sequoia-hope/rp2350-motor-controller/hardware/docs/snor027/LM73100_Design_Calculator.xlsm

Sheet: Calculation Sheet
LM73100 Design Calculation Tool
 | Constants Cells
 | Input/SelectCells
 | Calculation Cells
 | Calculated, but can be over-ridden by user
 | Error Cells, Must be Fixed
Parameter | Description | Value | Units | Tolerance | Recommended Value
VIN (max) | Maximum Operating input voltage (magnitude) | 12.00 | V
OVLO Set Point | Desired Over Voltage Lockout Set Point | 13.20 | V | 3.0%
UVLO Set Point | Desired Undervoltage Threshold (VIN Rising) | 10.80 | V | 3.0%
VUVP | Internal Undervoltage Protection Threshold (VIN Rising) | 2.53 | V | 3.0%
Cout | Load Capacitance | 470.0 | uF | 10.0%
Rlstart | Load at startup | 100.0 | Ohm |  | 2.4
Load turn on voltage | Output voltage at which startup load will start drawing current | 0 | V
Imax | Maximum continuous load current (magnitude) | 5.00 | A
TA, MAX | Maximum Operating Ambient temperature | 25.00 | °C
UVLO, OVLO set point calculations |  |  |  |  |  |  |  |  | R2+R3
UVLO Set Point | Desired Undervoltage Threshold (VIN Rising) | 10.80 |  |  |  |  |  |  | 58.75
OVLO Set Point | Desired Over Voltage Lockout Set Point | 13.20 |  |  |  |  | 9.80 | Power Fail (VIN Falling) | R2
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
