sequoia-hope/rp2350-motor-controller/review/img/enc_full-1.png

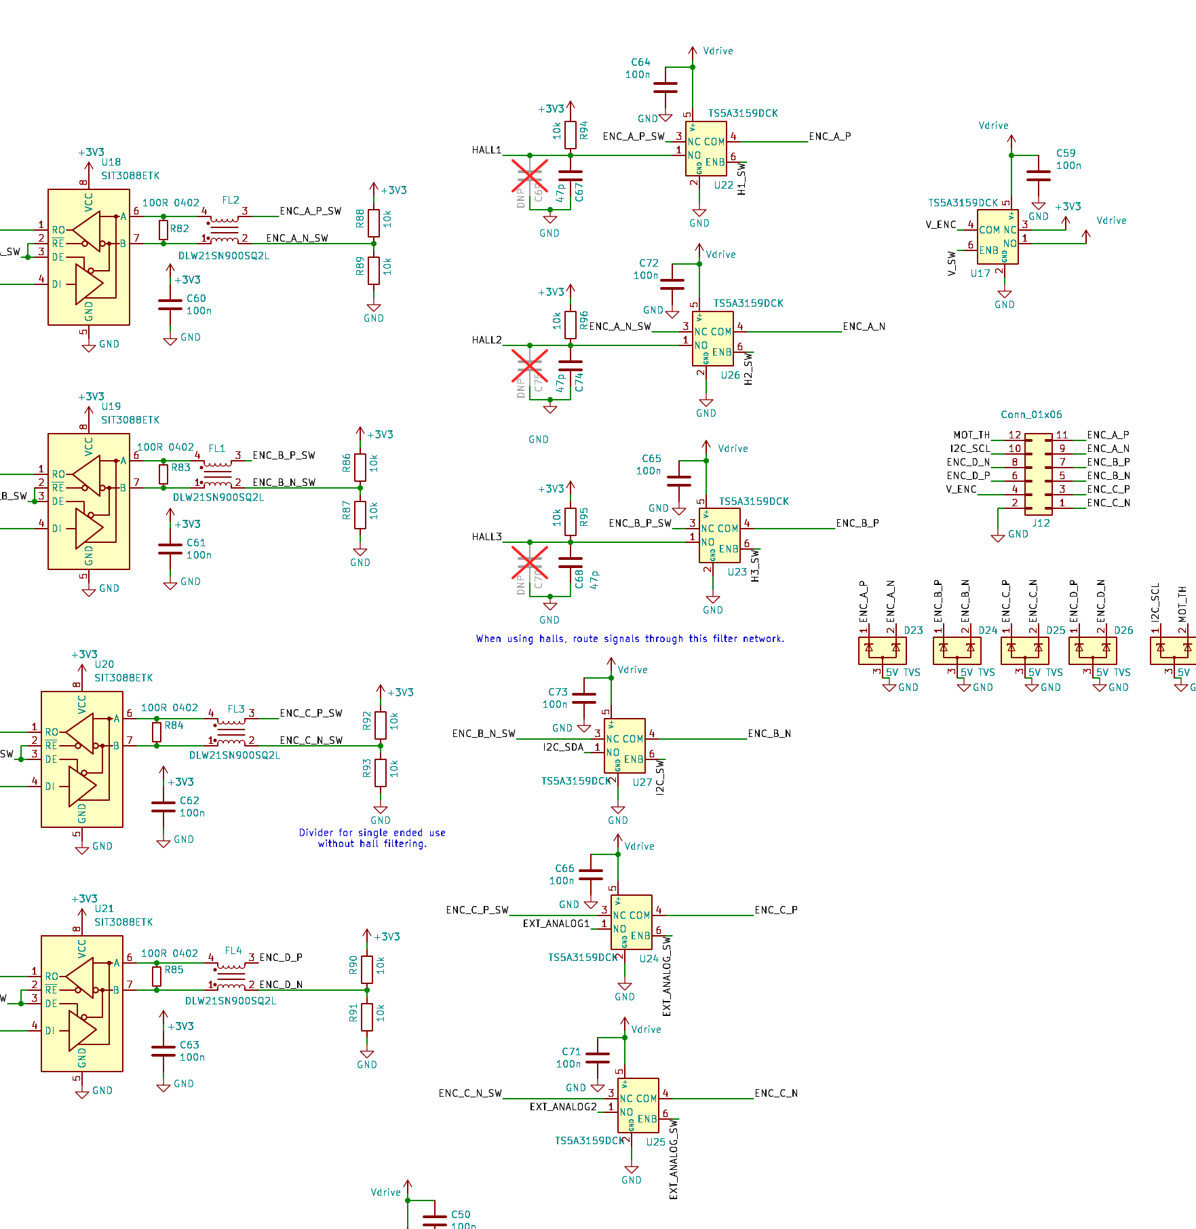
review/img/enc_full-1.png
