sequoia-hope/rp2350-motor-controller/review/img/encoder.png

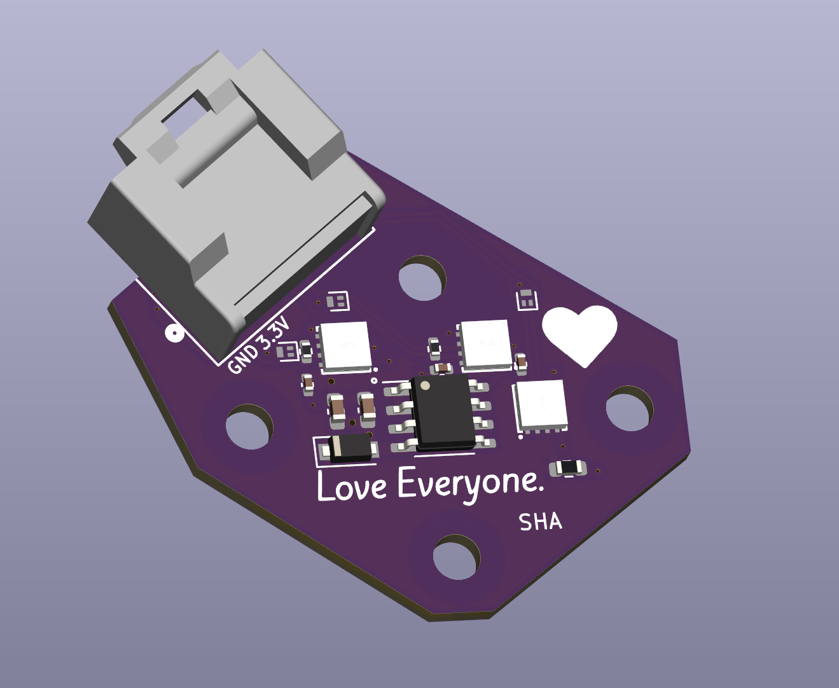
review/img/encoder.png
