sequoia-hope/rp2350-motor-controller/review/img/pcb_bottom.png

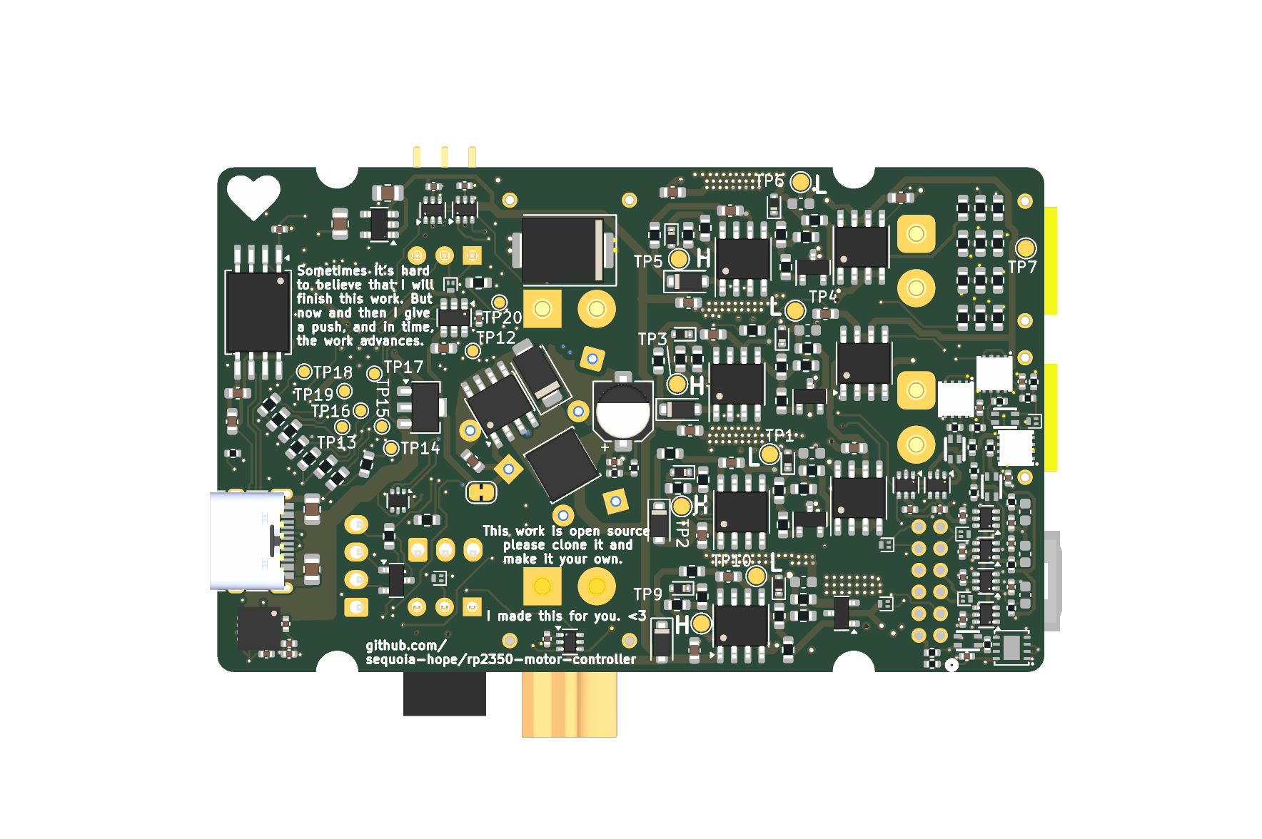
review/img/pcb_bottom.png
