sequoia-hope/rp2350-motor-controller/review/img/pcb_encoder_corner.png

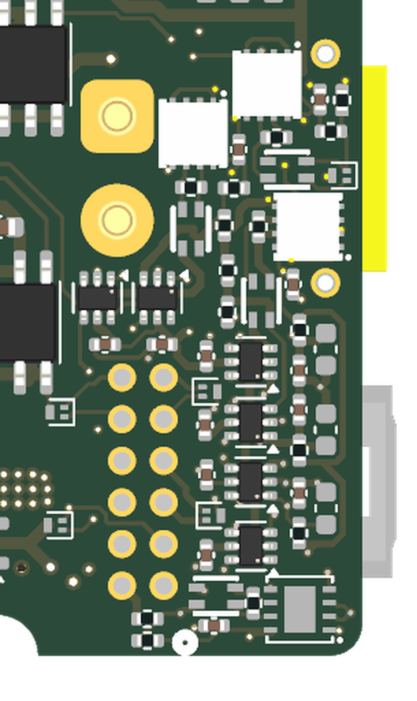
review/img/pcb_encoder_corner.png
