sequoia-hope/rp2350-motor-controller/review/img/pcb_top.png

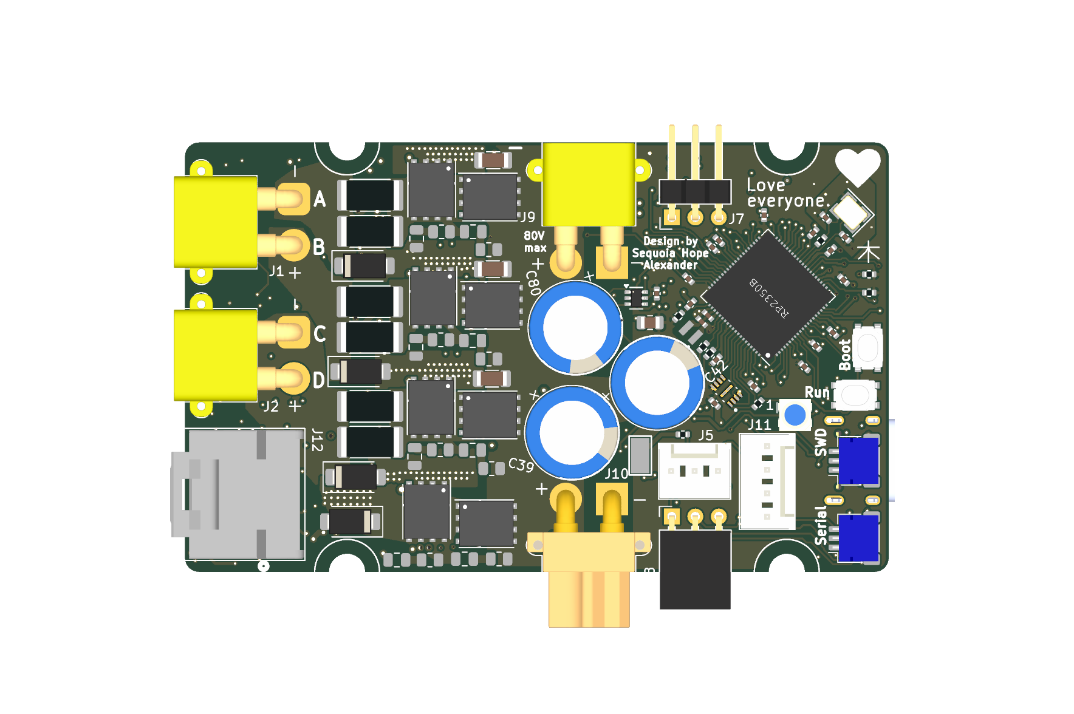
review/img/pcb_top.png
