sequoia-hope/rp2350-motor-controller/hardware/board.step

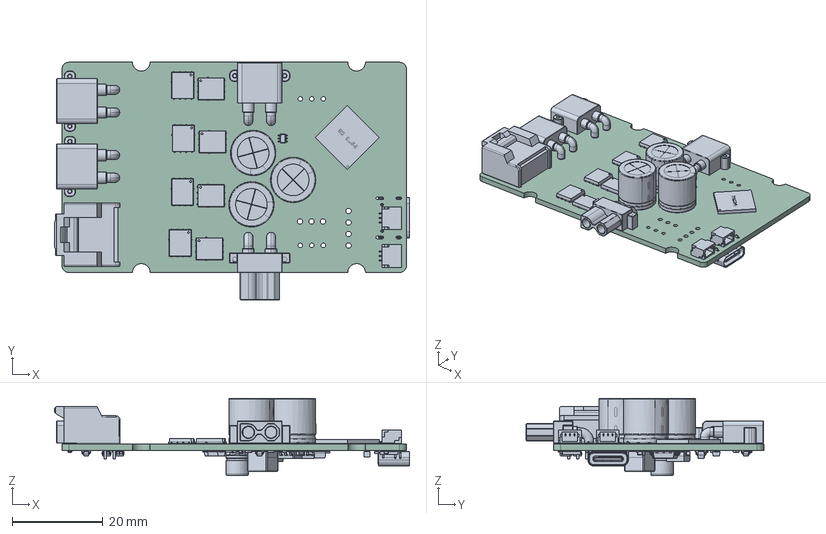
[picture p12: CAD file, 2026-05-27]
hardware/board.step
78.3 x 52.4 x 17.1 mm
CP_Radial_D10.0mm_P5.00mm x 3
KEY-SMD_4P-L4.2-W3.2-P2.20-LS4.6 x 2
PowerPAK-SO8 x 8
XT30PW-M--3DModel-STEP-269445 x 3
SM03B-SRSS-TB x 2
RP2350_QFN80
XT30PW-F
SOT-363_SC-70-6 x 10
QFN-16-1EP_4x4mm_P0.65mm_EP2.5x2.5mm
C_0402_1005Metric x 6
C_0603_1608Metric x 2
D_SMA
SOIC-8-1EP_3.9x4.9mm_P1.27mm_EP2.29x3mm
D_SOD-123F x 4
DFN-8_L3.0-W3.0-P0.65-BL-EP x 3
C_0805_2012Metric x 2
SOT-23-6
R_0402_1005Metric x 2
CP_Elec_5x5.4
USB4125-GF-A-0190--3DModel-STEP-56544
board 1.51.1
L_APV_ANR5045
rp2350_driver_PCB
