sequoia-hope/rp2350-motor-controller/hardware/encoder/parts/Molex_90Grad_5er.STEP

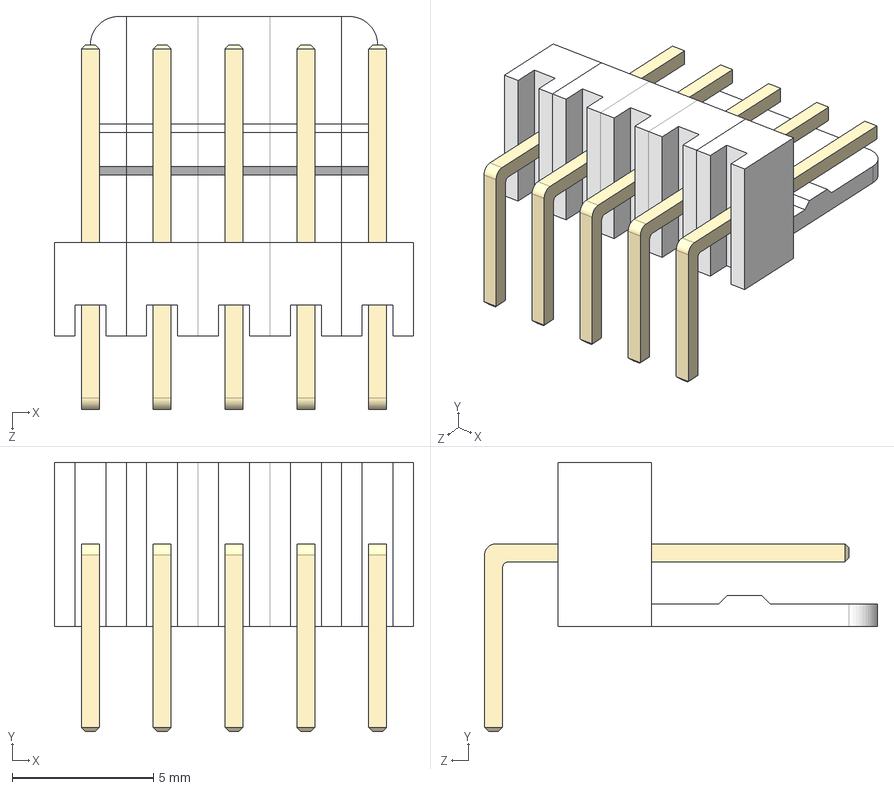
[picture p13: CAD file, 2026-05-27]
hardware/encoder/parts/Molex_90Grad_5er.STEP
12.7 x 9.52 x 13.9 mm
Molex_Stecker_90Grad_rechts
Molex_Stecker_90Grad_links
Molex_Stecker_90Grad_mitte x 3
