sequoia-hope/rp2350-motor-controller/hardware/parts/KEY-SMD_4P-L4.2-W3.2-P2.20-LS4.6.obj

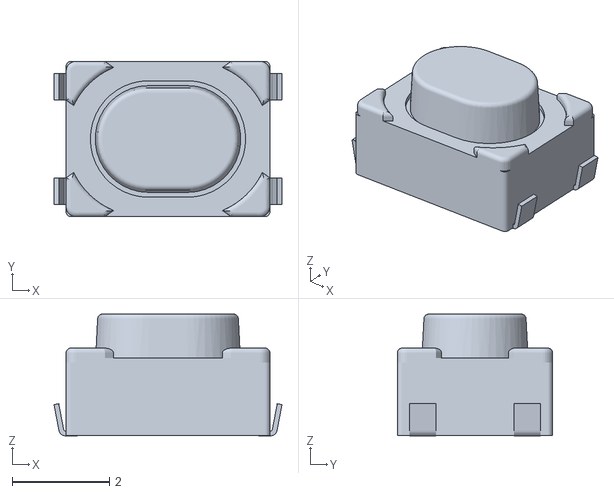
[picture p14: CAD file, 2025-01-25]
hardware/parts/KEY-SMD_4P-L4.2-W3.2-P2.20-LS4.6.obj
4.70 x 3.20 x 2.51
