sequoia-hope/rp2350-motor-controller/hardware/encoder/parts/CONN-TH_6P-P2.54_HCTL_HC-2510-6AW.obj

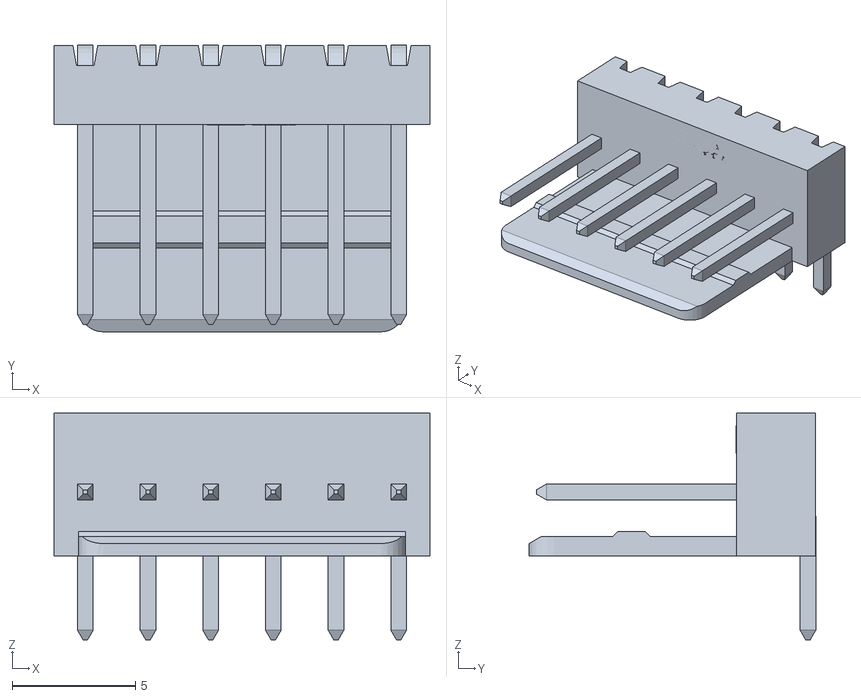
[picture p15: CAD file, 2026-05-27]
hardware/encoder/parts/CONN-TH_6P-P2.54_HCTL_HC-2510-6AW.obj
15.2 x 11.6 x 9.20
