sequoia-hope/rp2350-motor-controller/hardware/parts/SOT-883-3_L1.0-W0.6-BR.obj

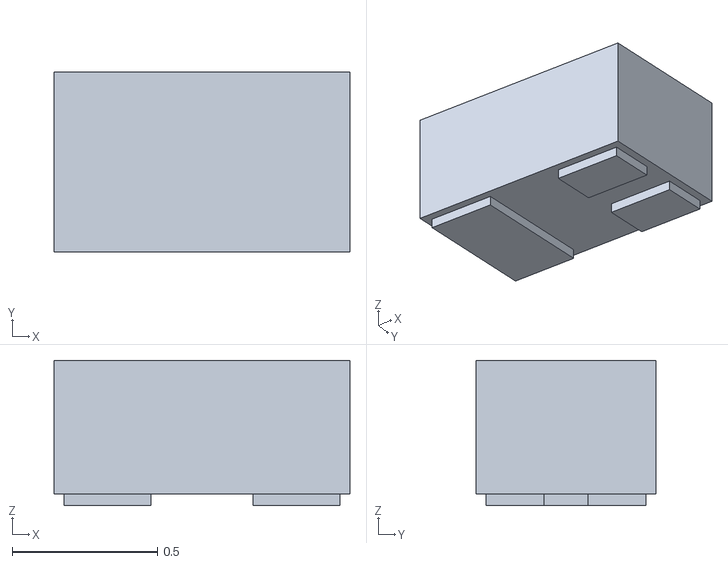
[picture p16: CAD file, 2025-01-19]
hardware/parts/SOT-883-3_L1.0-W0.6-BR.obj
1.02 x 0.62 x 0.5
