sequoia-hope/rp2350-motor-controller/hardware/parts/SOT-723_L1.2-W0.8-P0.40-LS1.2-BR.obj

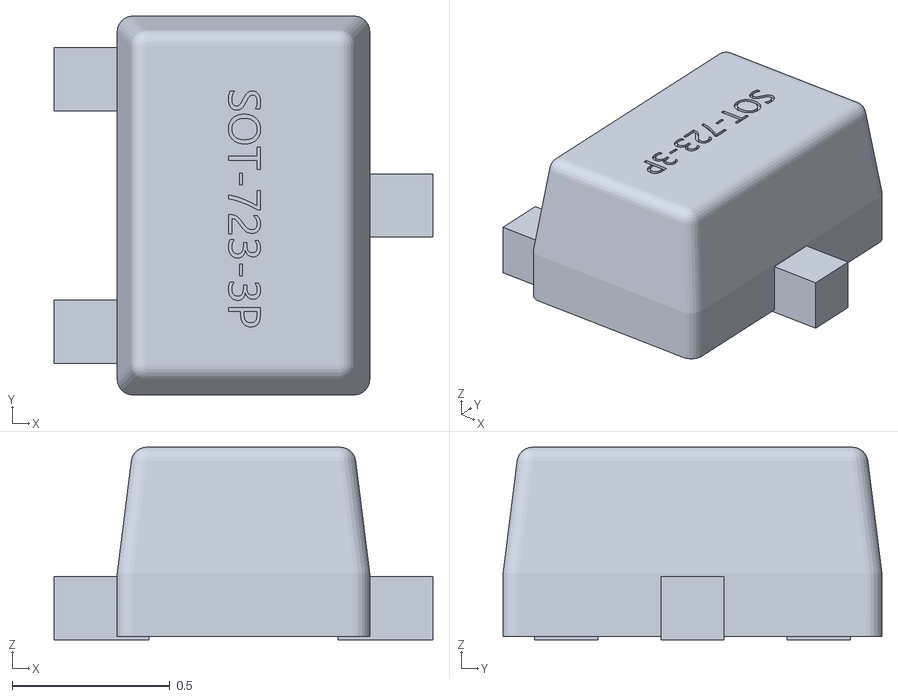
[picture p18: CAD file, 2025-01-19]
hardware/parts/SOT-723_L1.2-W0.8-P0.40-LS1.2-BR.obj
1.20 x 1.20 x 0.61
