sequoia-hope/rp2350-motor-controller/hardware/parts/DFN-6_L1.6-W1.0-P0.50-BL.obj

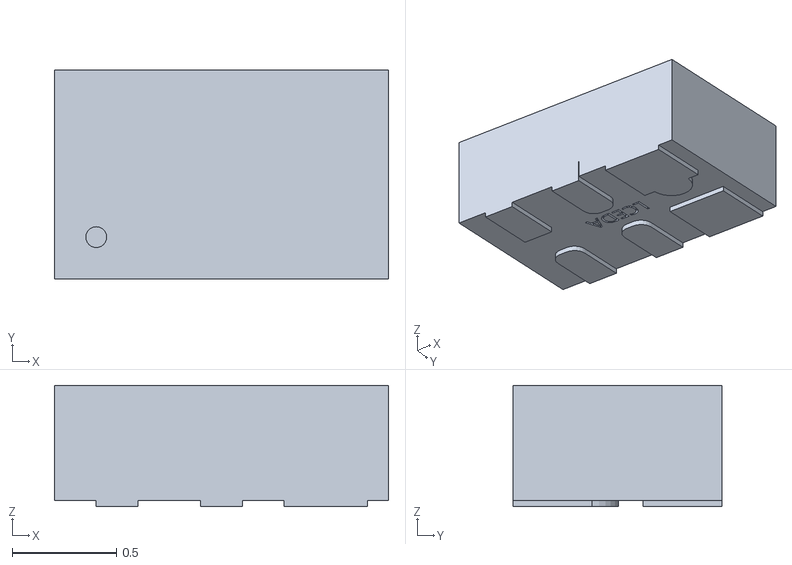
[picture p19: CAD file, 2025-01-19]
hardware/parts/DFN-6_L1.6-W1.0-P0.50-BL.obj
1.60 x 1.00 x 0.58
