sequoia-hope/rp2350-motor-controller/hardware/parts/FILTER-SMD_4P-L2.0-W1.2-BL_DLW21H.obj

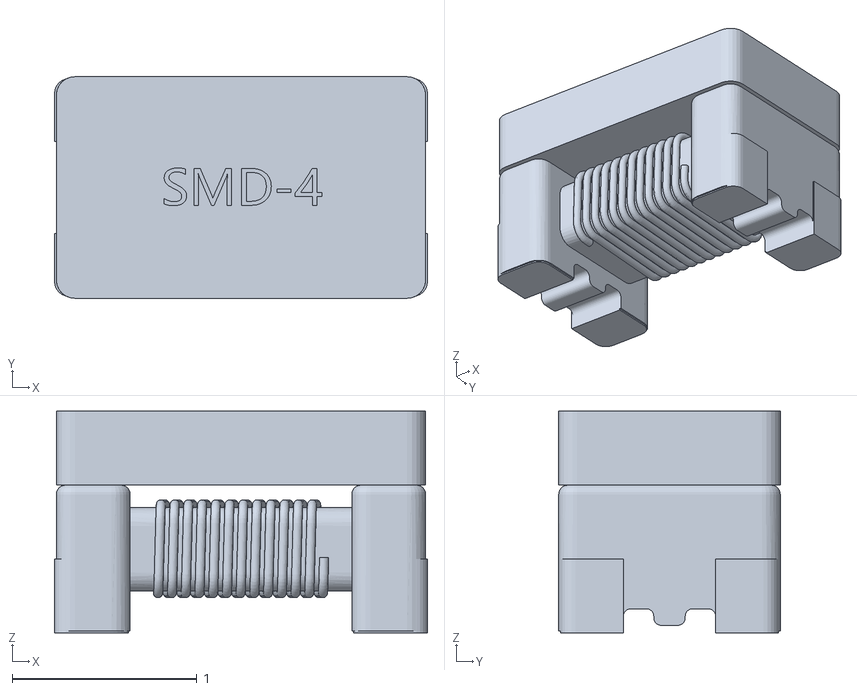
[picture p20: CAD file, 2025-01-19]
hardware/parts/FILTER-SMD_4P-L2.0-W1.2-BL_DLW21H.obj
2.02 x 1.20 x 1.20
