sequoia-hope/rp2350-motor-controller/hardware/parts/HDR-TH_12P-P2.00-H-M_PM200-2-06-W-4.3.obj

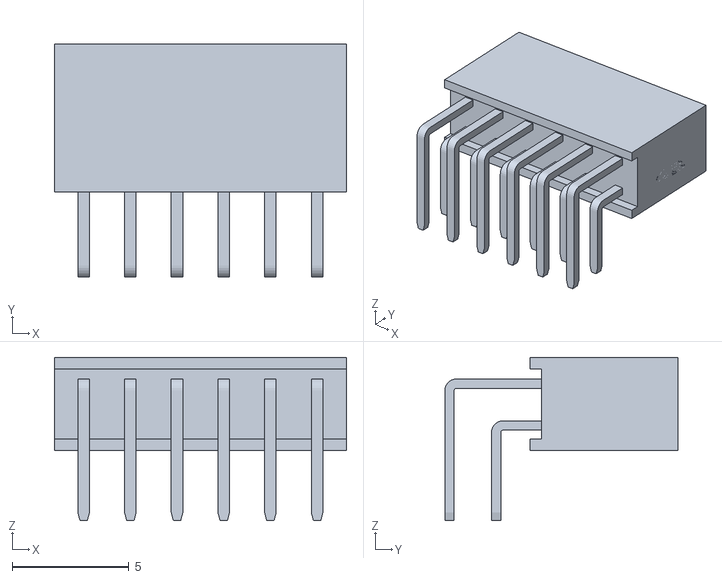
[picture p21: CAD file, 2024-12-18]
hardware/parts/HDR-TH_12P-P2.00-H-M_PM200-2-06-W-4.3.obj
12.5 x 10.0 x 7.00
