sequoia-hope/rp2350-motor-controller/hardware/parts/DFN-8_L3.0-W3.0-P0.65-BL-EP.obj

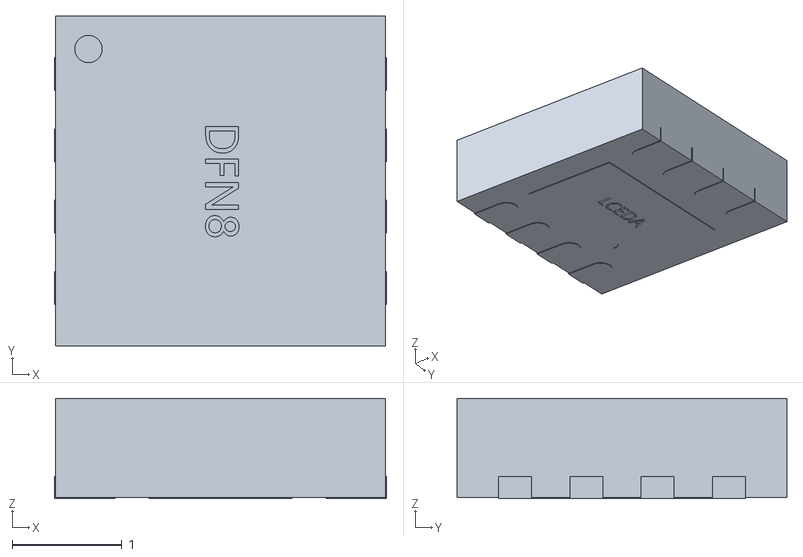
[picture p22: CAD file, 2024-12-18]
hardware/parts/DFN-8_L3.0-W3.0-P0.65-BL-EP.obj
3.02 x 3.00 x 0.91
