sequoia-hope/rp2350-motor-controller/hardware/parts/CONN-TH_12P-P3.00_HC-MX3.0-2X6AW_1.obj

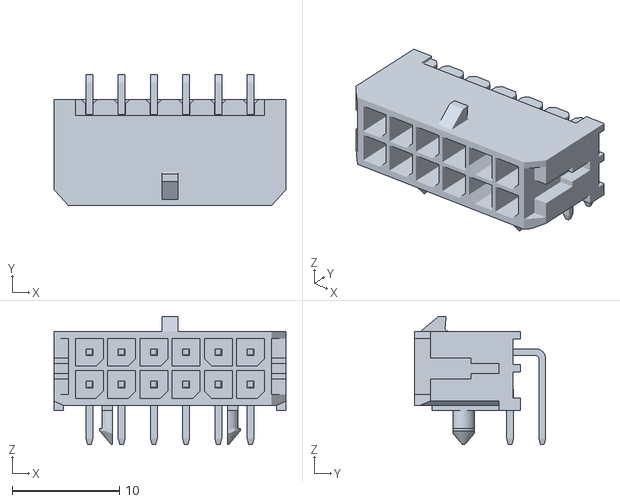
[picture p23: CAD file, 2024-12-18]
hardware/parts/CONN-TH_12P-P3.00_HC-MX3.0-2X6AW_1.obj
21.6 x 12.2 x 12.0
