sequoia-hope/rp2350-motor-controller/hardware/parts/PowerPAK-SO8.STEP

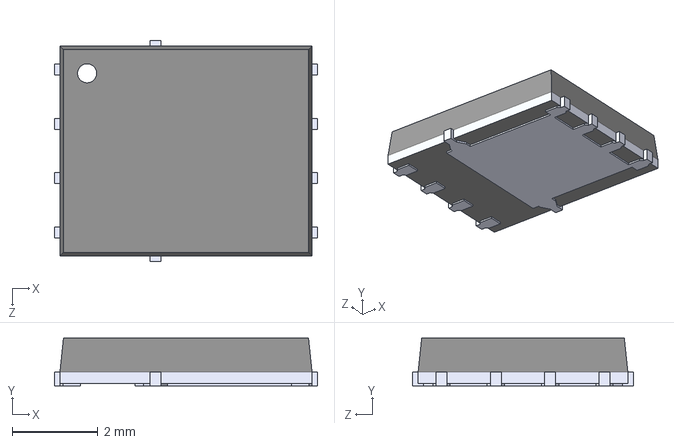
[picture p24: CAD file, 2024-12-02]
hardware/parts/PowerPAK-SO8.STEP
6.15 x 1.12 x 5.16 mm
