sequoia-hope/rp2350-motor-controller/hardware/parts/SM03B-SRSS-TB.STEP

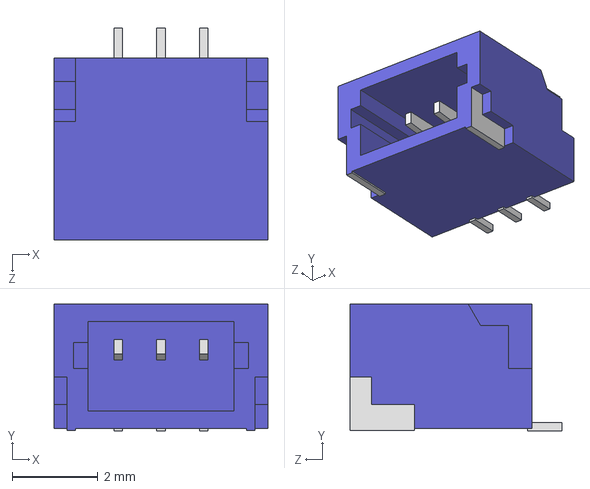
[picture p25: CAD file, 2024-12-02]
hardware/parts/SM03B-SRSS-TB.STEP
5.00 x 2.96 x 4.95 mm
