sequoia-hope/rp2350-motor-controller/hardware/parts/sk6812_1.5x1.5mm.step

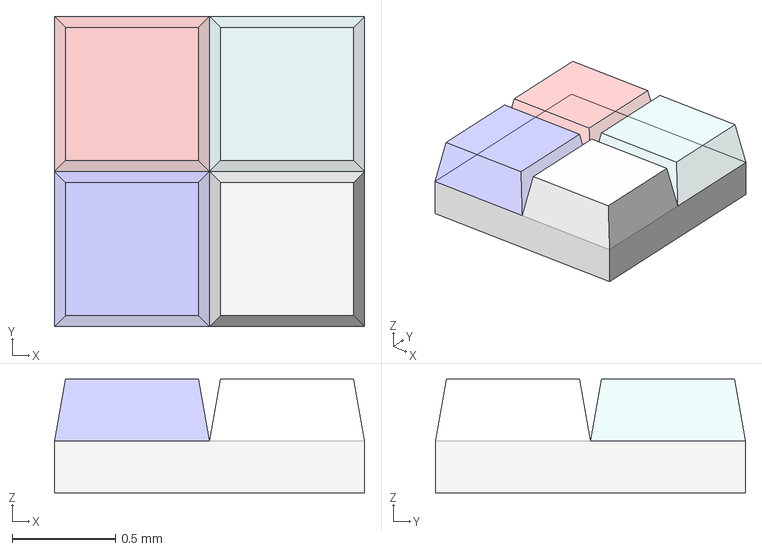
[picture p26: CAD file, 2024-12-02]
hardware/parts/sk6812_1.5x1.5mm.step
1.50 x 1.50 x 0.55 mm
