sequoia-hope/rp2350-motor-controller/hardware/parts/BM03B-SRSS-TB (copy).STEP

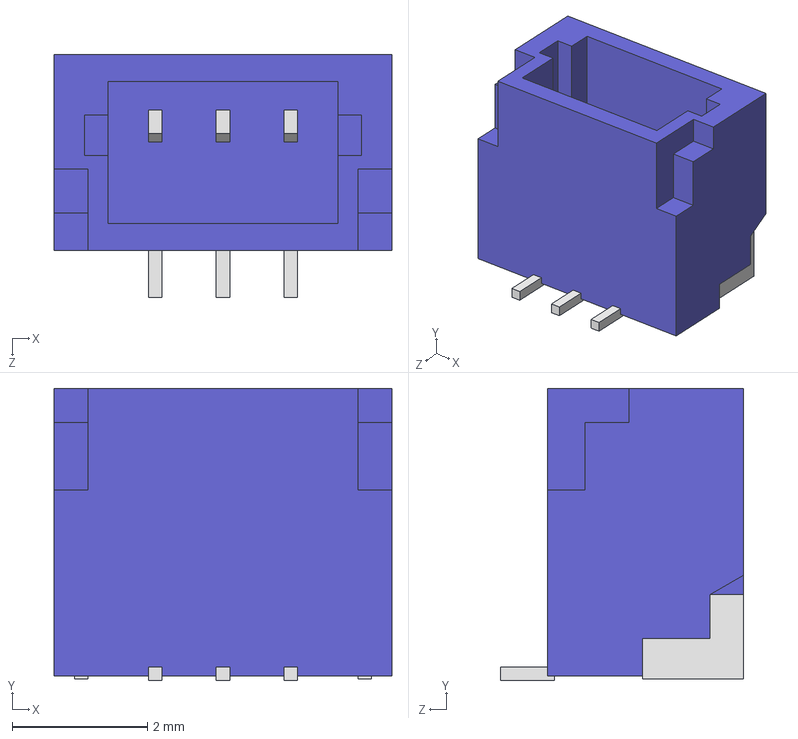
[picture p27: CAD file, 2024-12-02]
hardware/parts/BM03B-SRSS-TB (copy).STEP
5.00 x 4.32 x 3.60 mm
