sequoia-hope/rp2350-motor-controller/hardware/parts/RP2350_QFN80.step

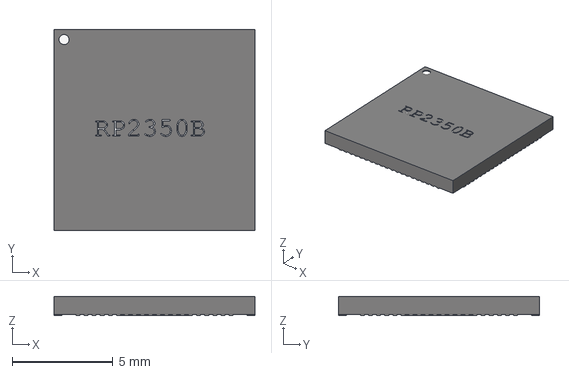
[picture p28: CAD file, 2024-11-29]
hardware/parts/RP2350_QFN80.step
10.0 x 10.0 x 0.95 mm
