sequoia-hope/rp2350-motor-controller/hardware/parts/USB4125-GF-A-0190--3DModel-STEP-56544.STEP

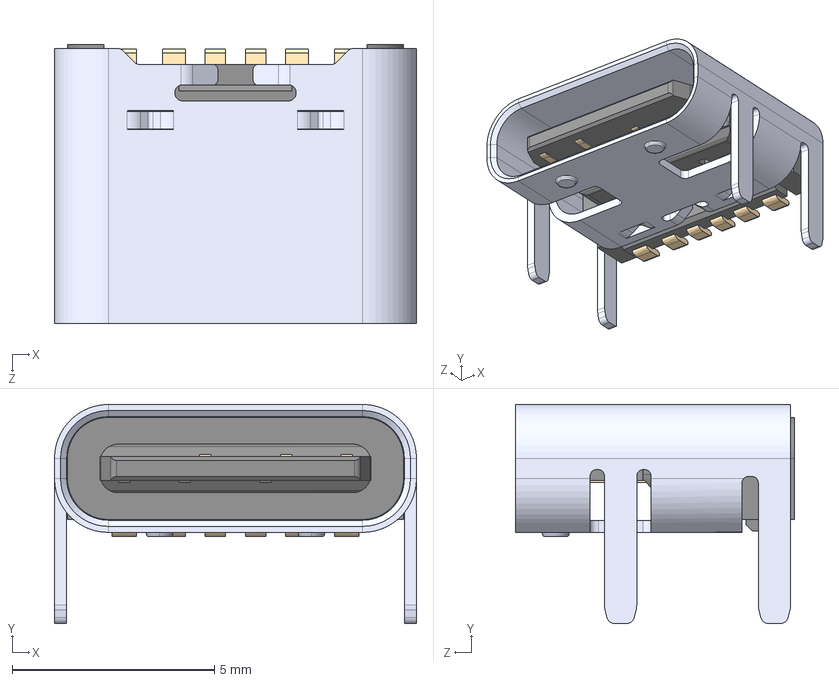
[picture p29: CAD file, 2024-11-29]
hardware/parts/USB4125-GF-A-0190--3DModel-STEP-56544.STEP
8.94 x 5.41 x 6.90 mm
