sequoia-hope/rp2350-motor-controller/(list of files, cad)

Other CAD files:
hardware/parts/026605040.stp
hardware/parts/430451010.stp
hardware/parts/460073104.stp
hardware/parts/5018761240.stp
hardware/parts/LM73100RPWR/LM73100RPWR.STEP
hardware/parts/LM73100RPWR/LM73100RPWR.step
