sequoia-hope/rp2350-motor-controller/hardware/rp2350_driver.pdf

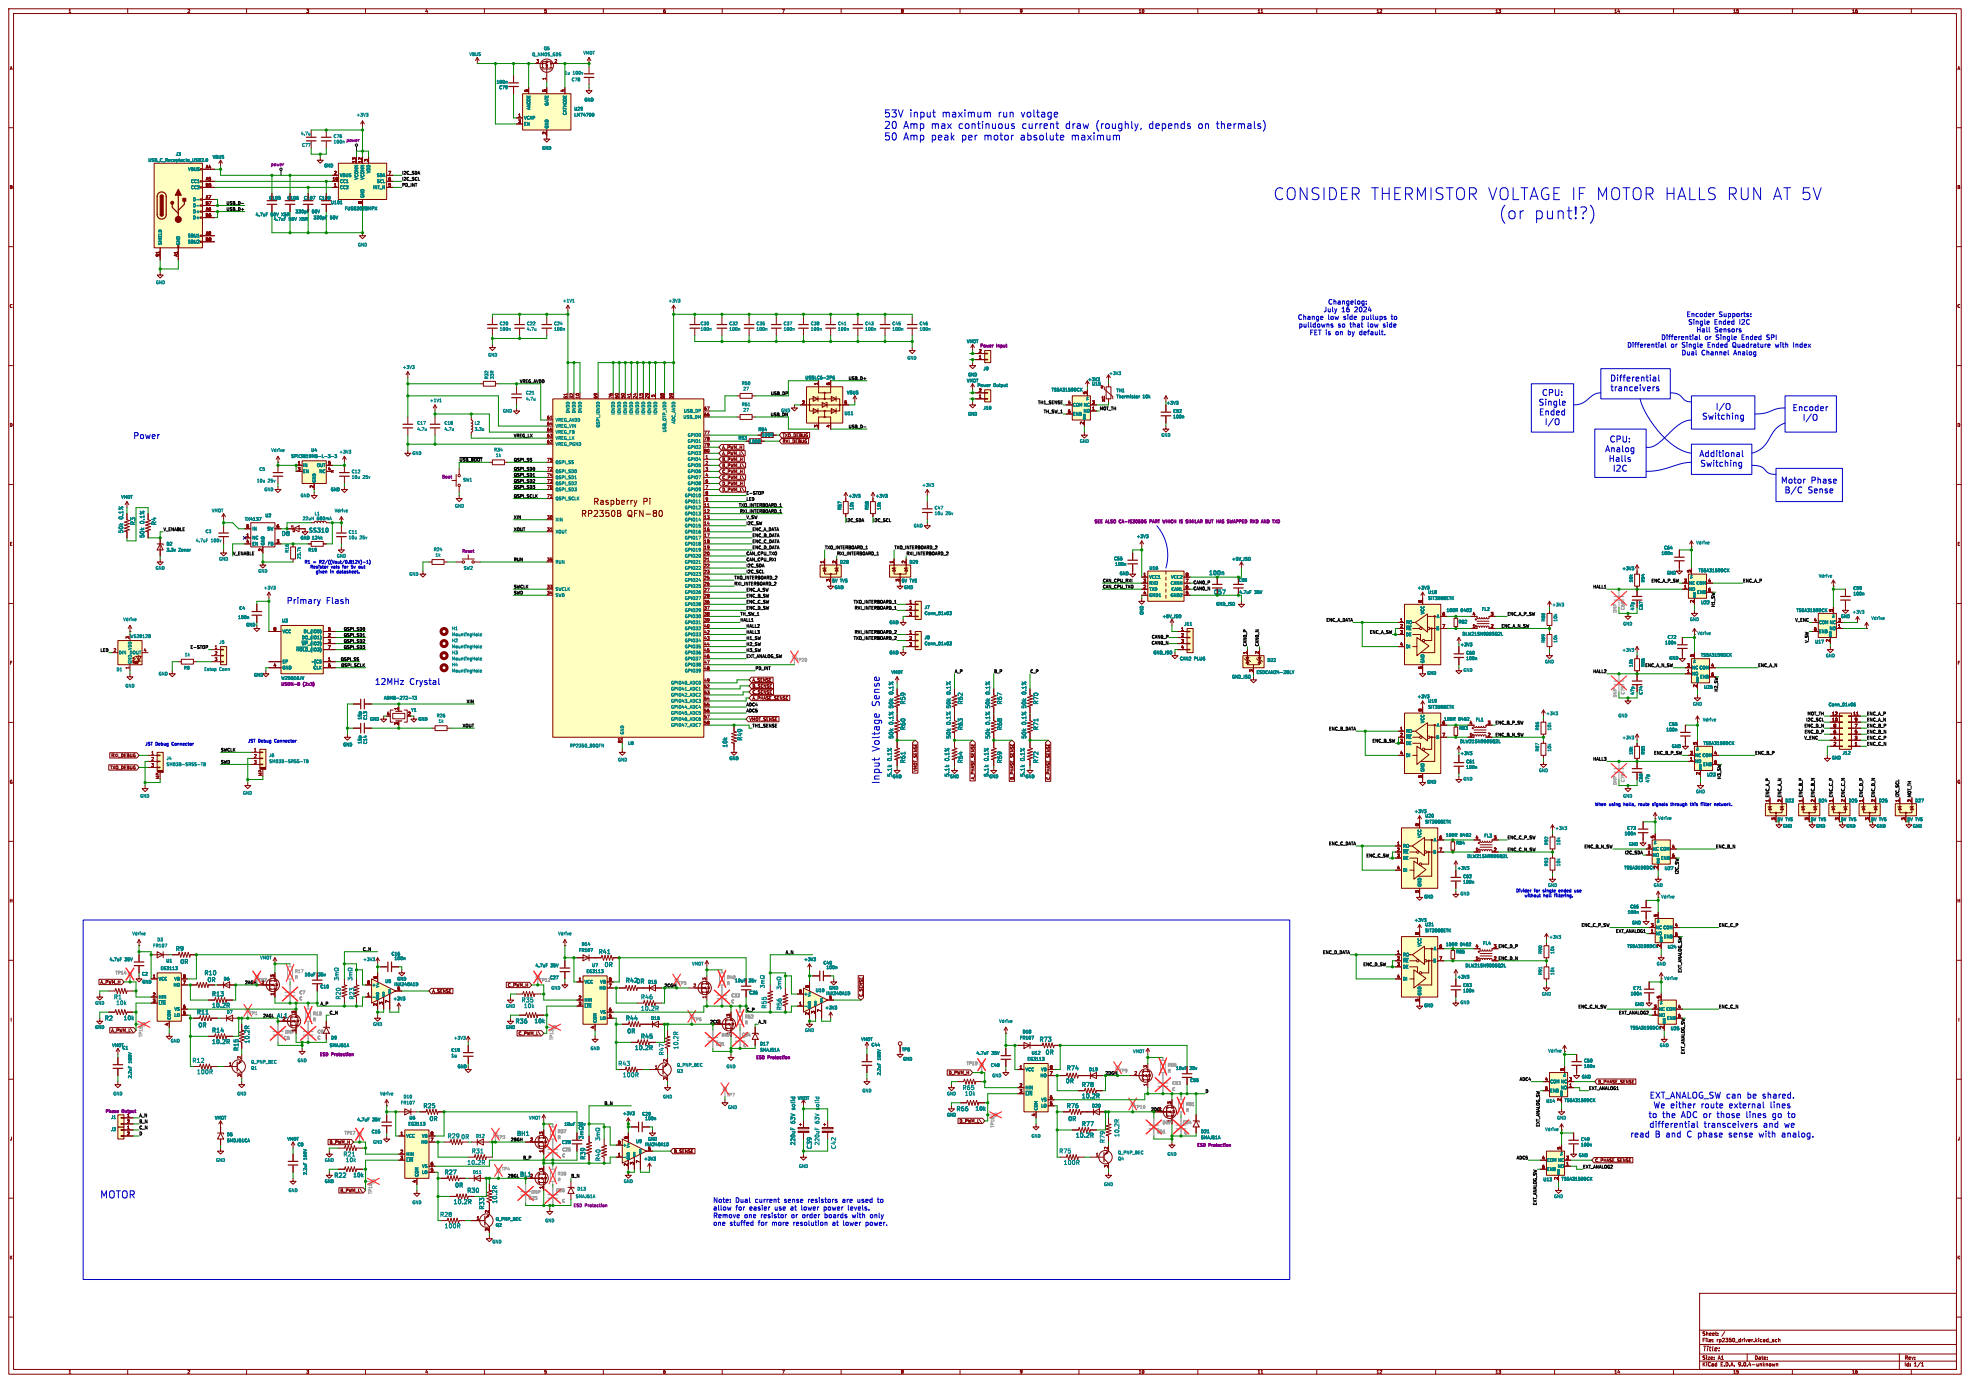
[picture p30: page 1]

53V input maximum run voltage
50 Amp peak per motor absolute maximum

CONSIDER THERMISTOR VOLTAGE IF MOTOR HALLS RUN AT 5V

2 OUT 5 NC 4 U4 SPX3819M5-L-3-3 TP15 GND R16 23.7k GND

Change low side pullups to
FET is on by default.

2 GND GND GND GND

R1 = R2/((Vout/0.812V)-1) Resistor vals for 5v out given in datasheet.

H1 MountingHole H3 MountingHole H4 MountingHole GND

Divider for single ended use without hall filtering.

EXT_ANALOG_SW can be shared.
We either route external lines
to the ADC or those lines go to

read B and C phase sense with analog.

allow for easier use at lower power levels.

Id: 1/1 Title: File: rp2350_driver.kicad_sch Sheet: /
