sequoia-hope/rp2350-motor-controller/hardware/rp2350_driver.kicad_pcb

## KiCad design hardware/rp2350_driver.kicad_pcb (2026-08-09)

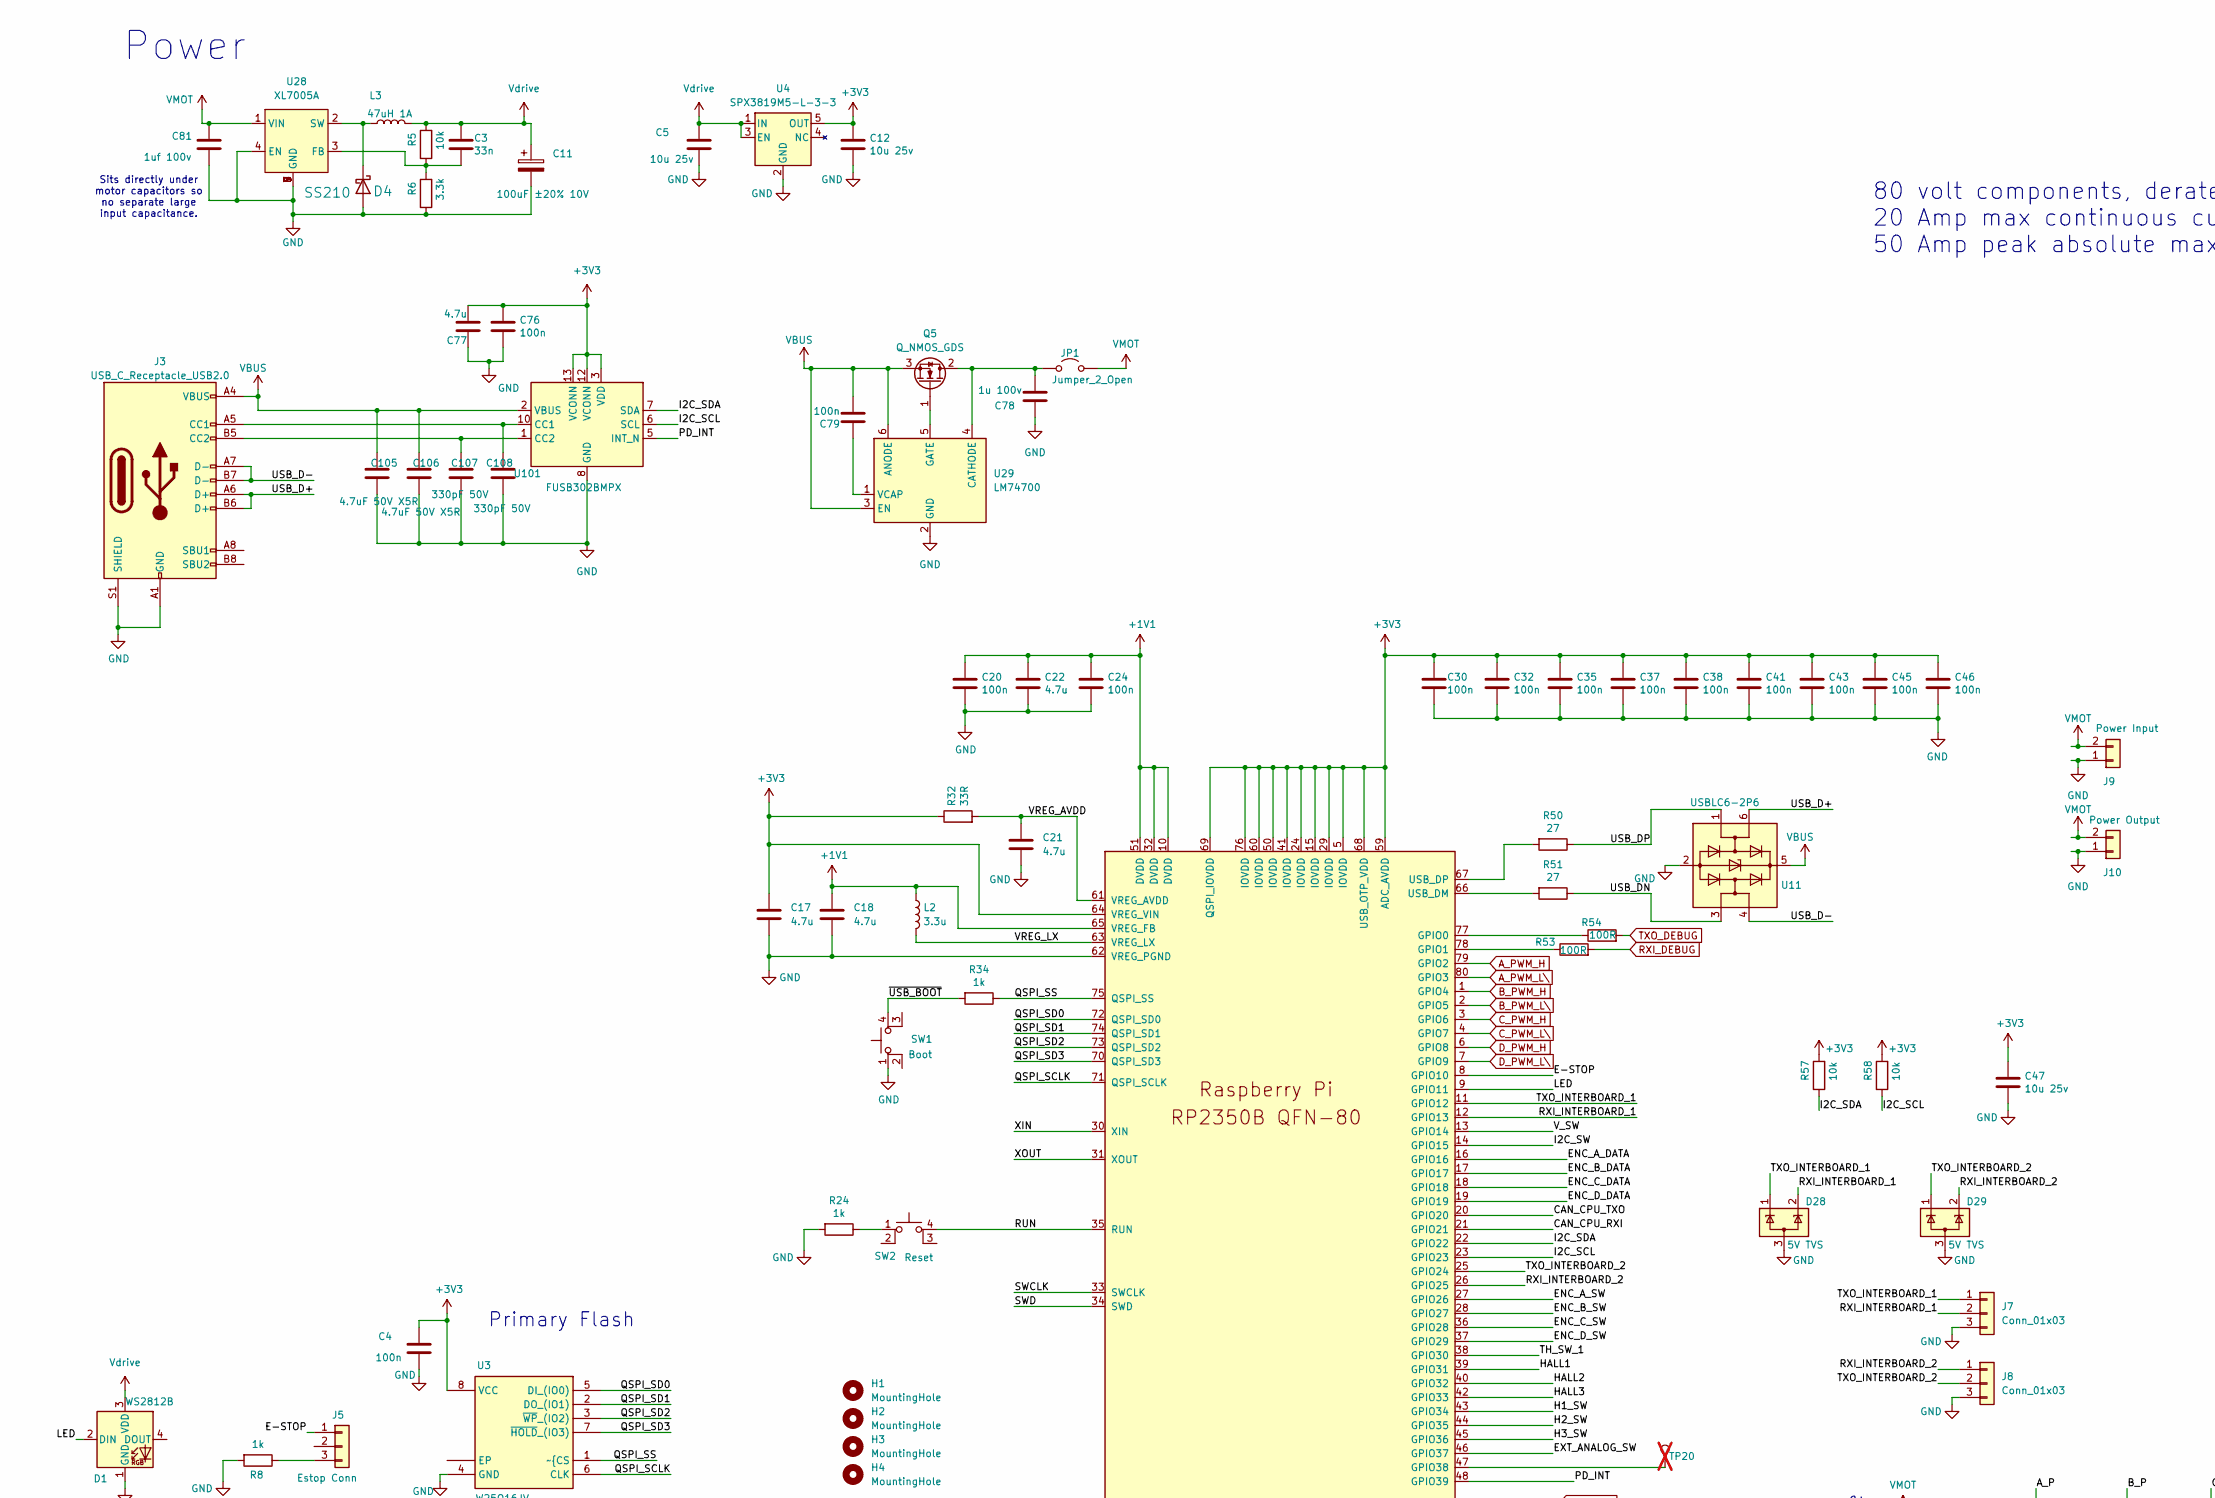
[picture p31: schematic rp2350_driver.kicad_sch, part in row 1, column 1]

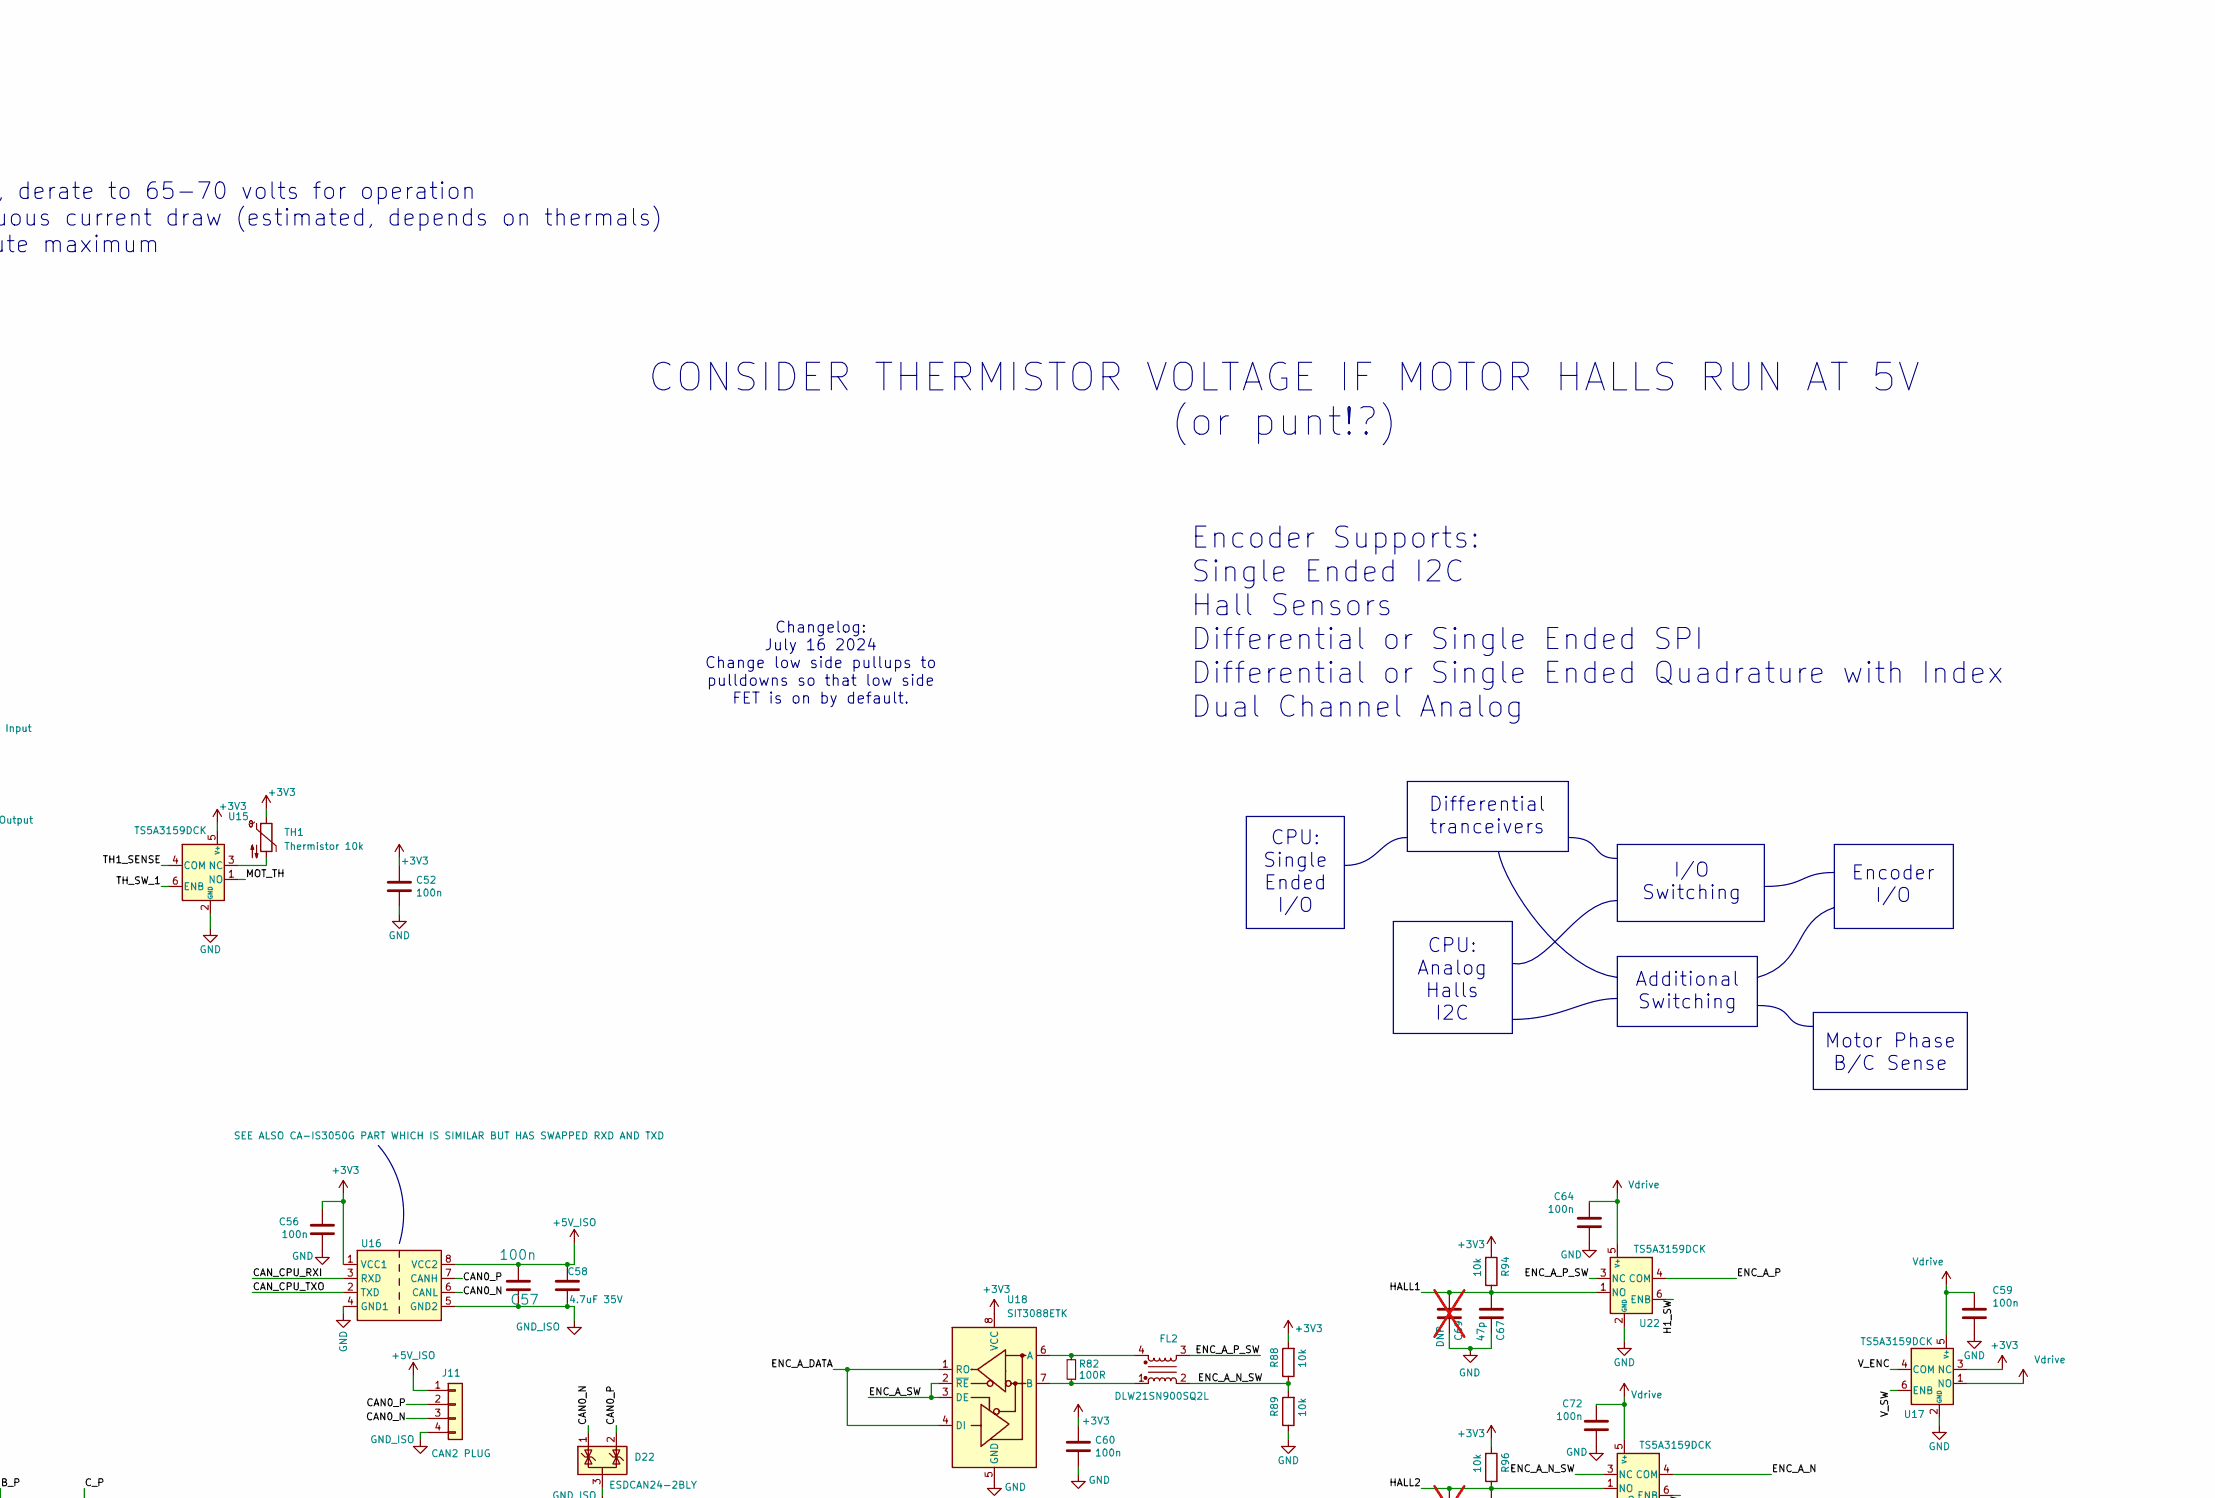
[picture p32: schematic rp2350_driver.kicad_sch, part in row 1, column 2]

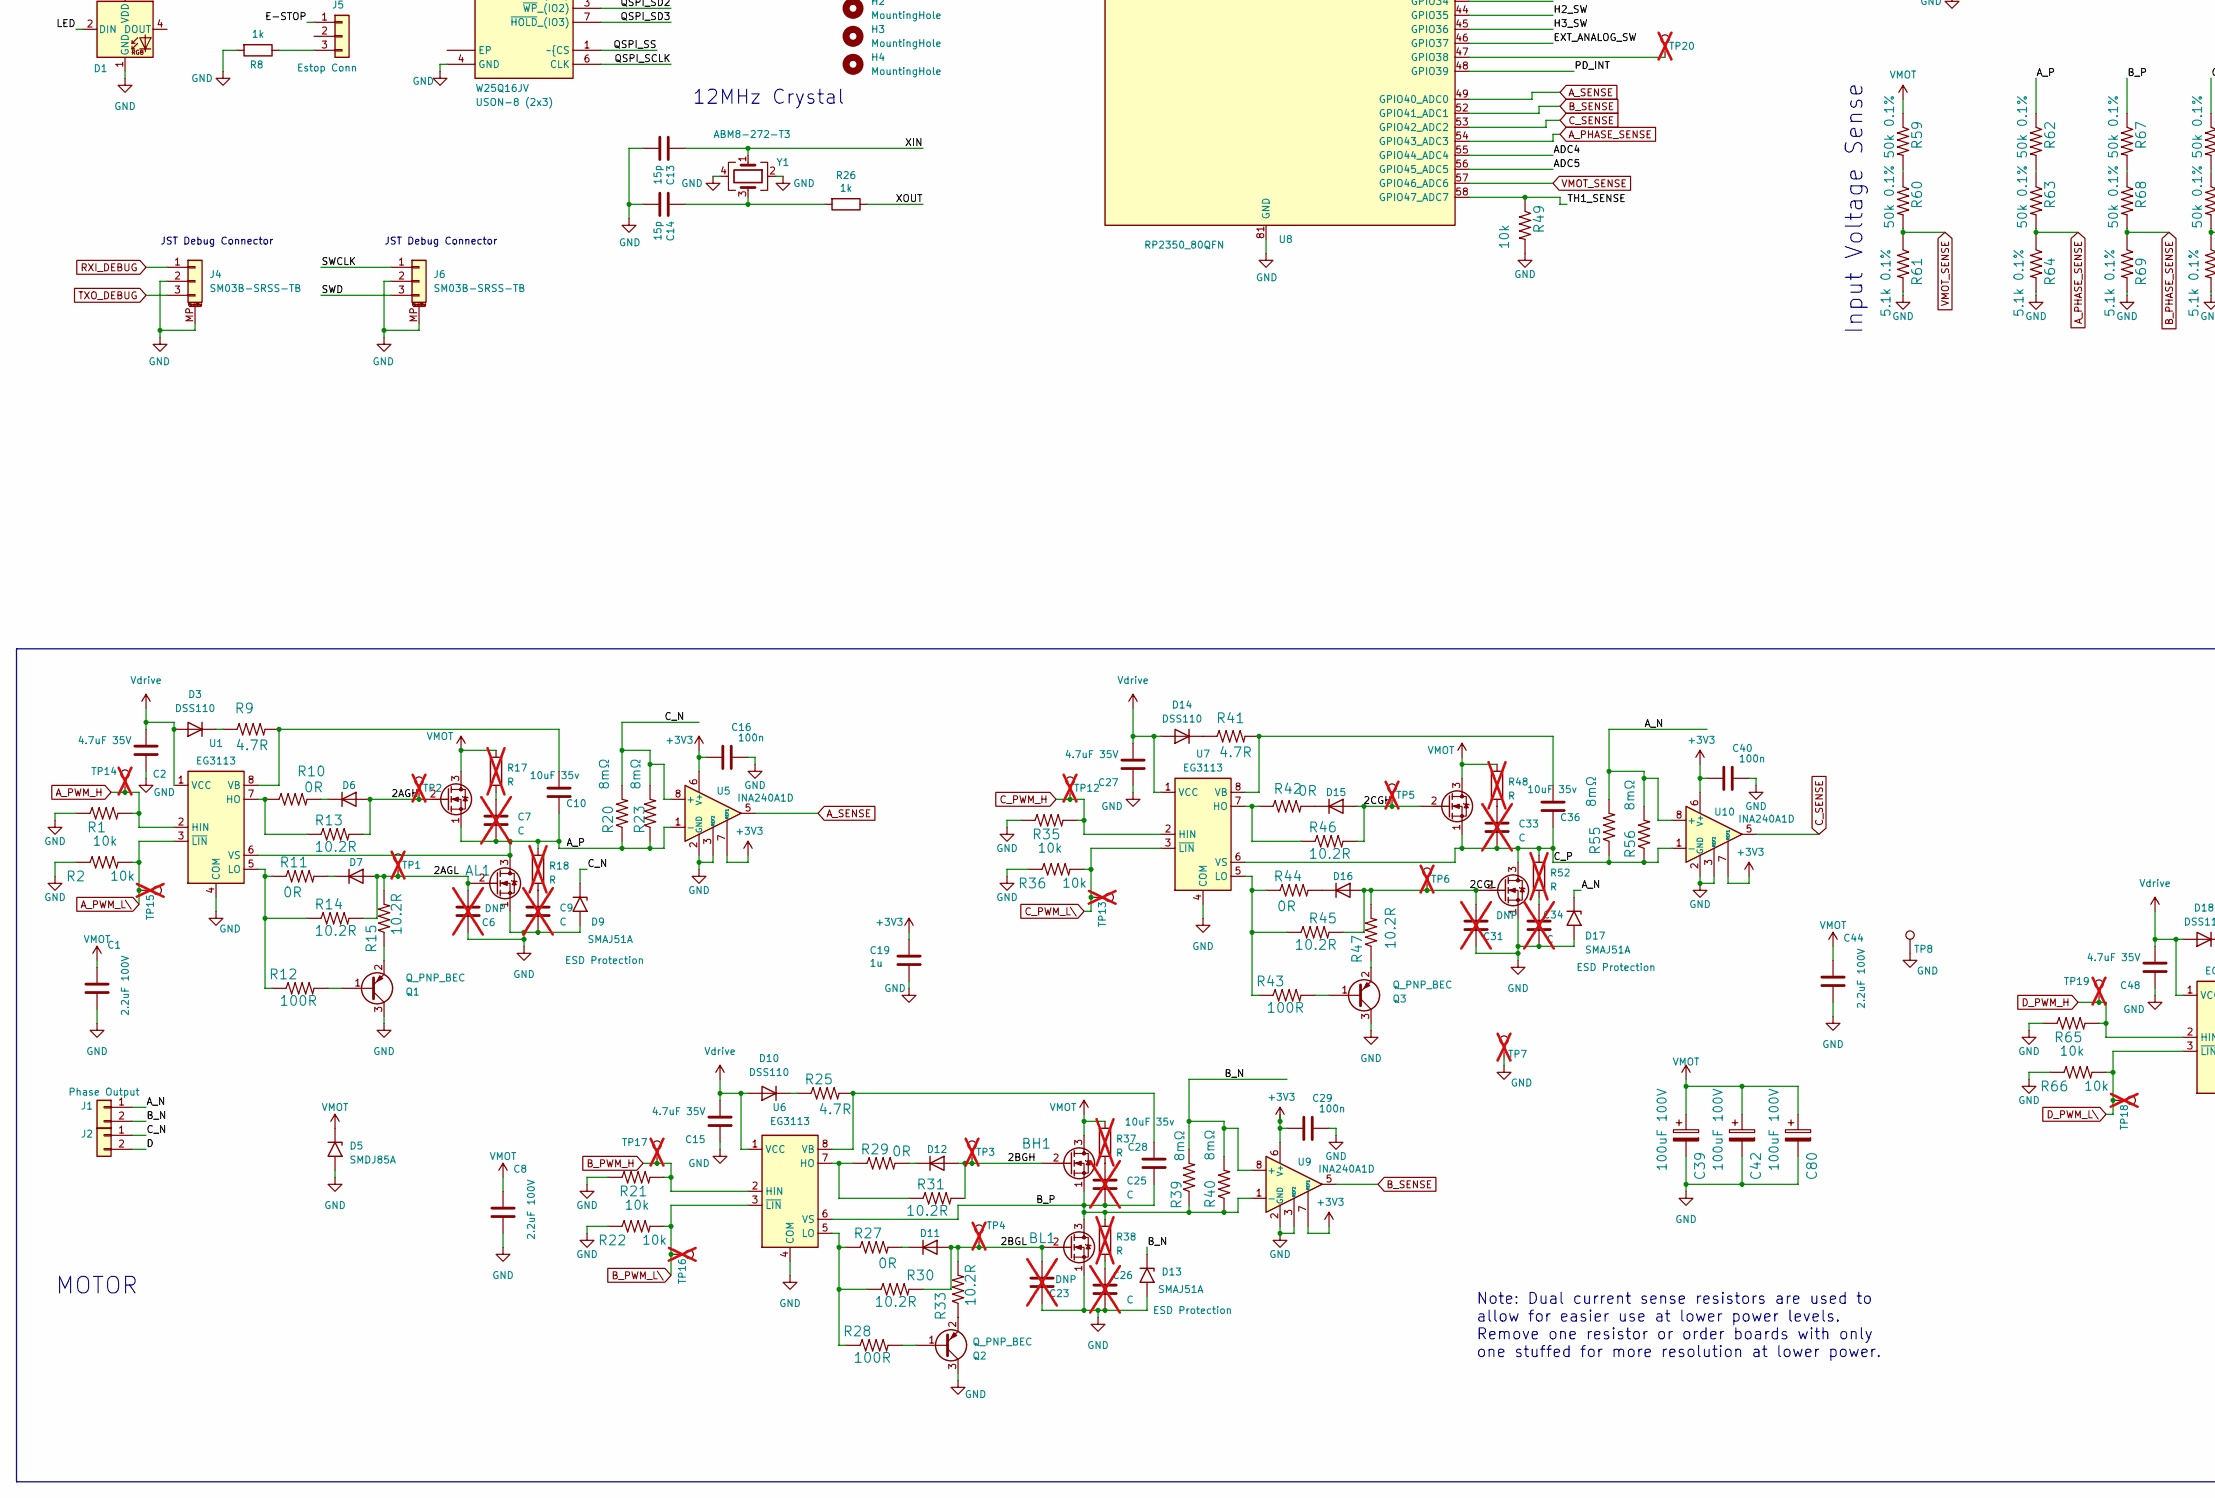
[picture p33: schematic rp2350_driver.kicad_sch, part in row 2, column 1]

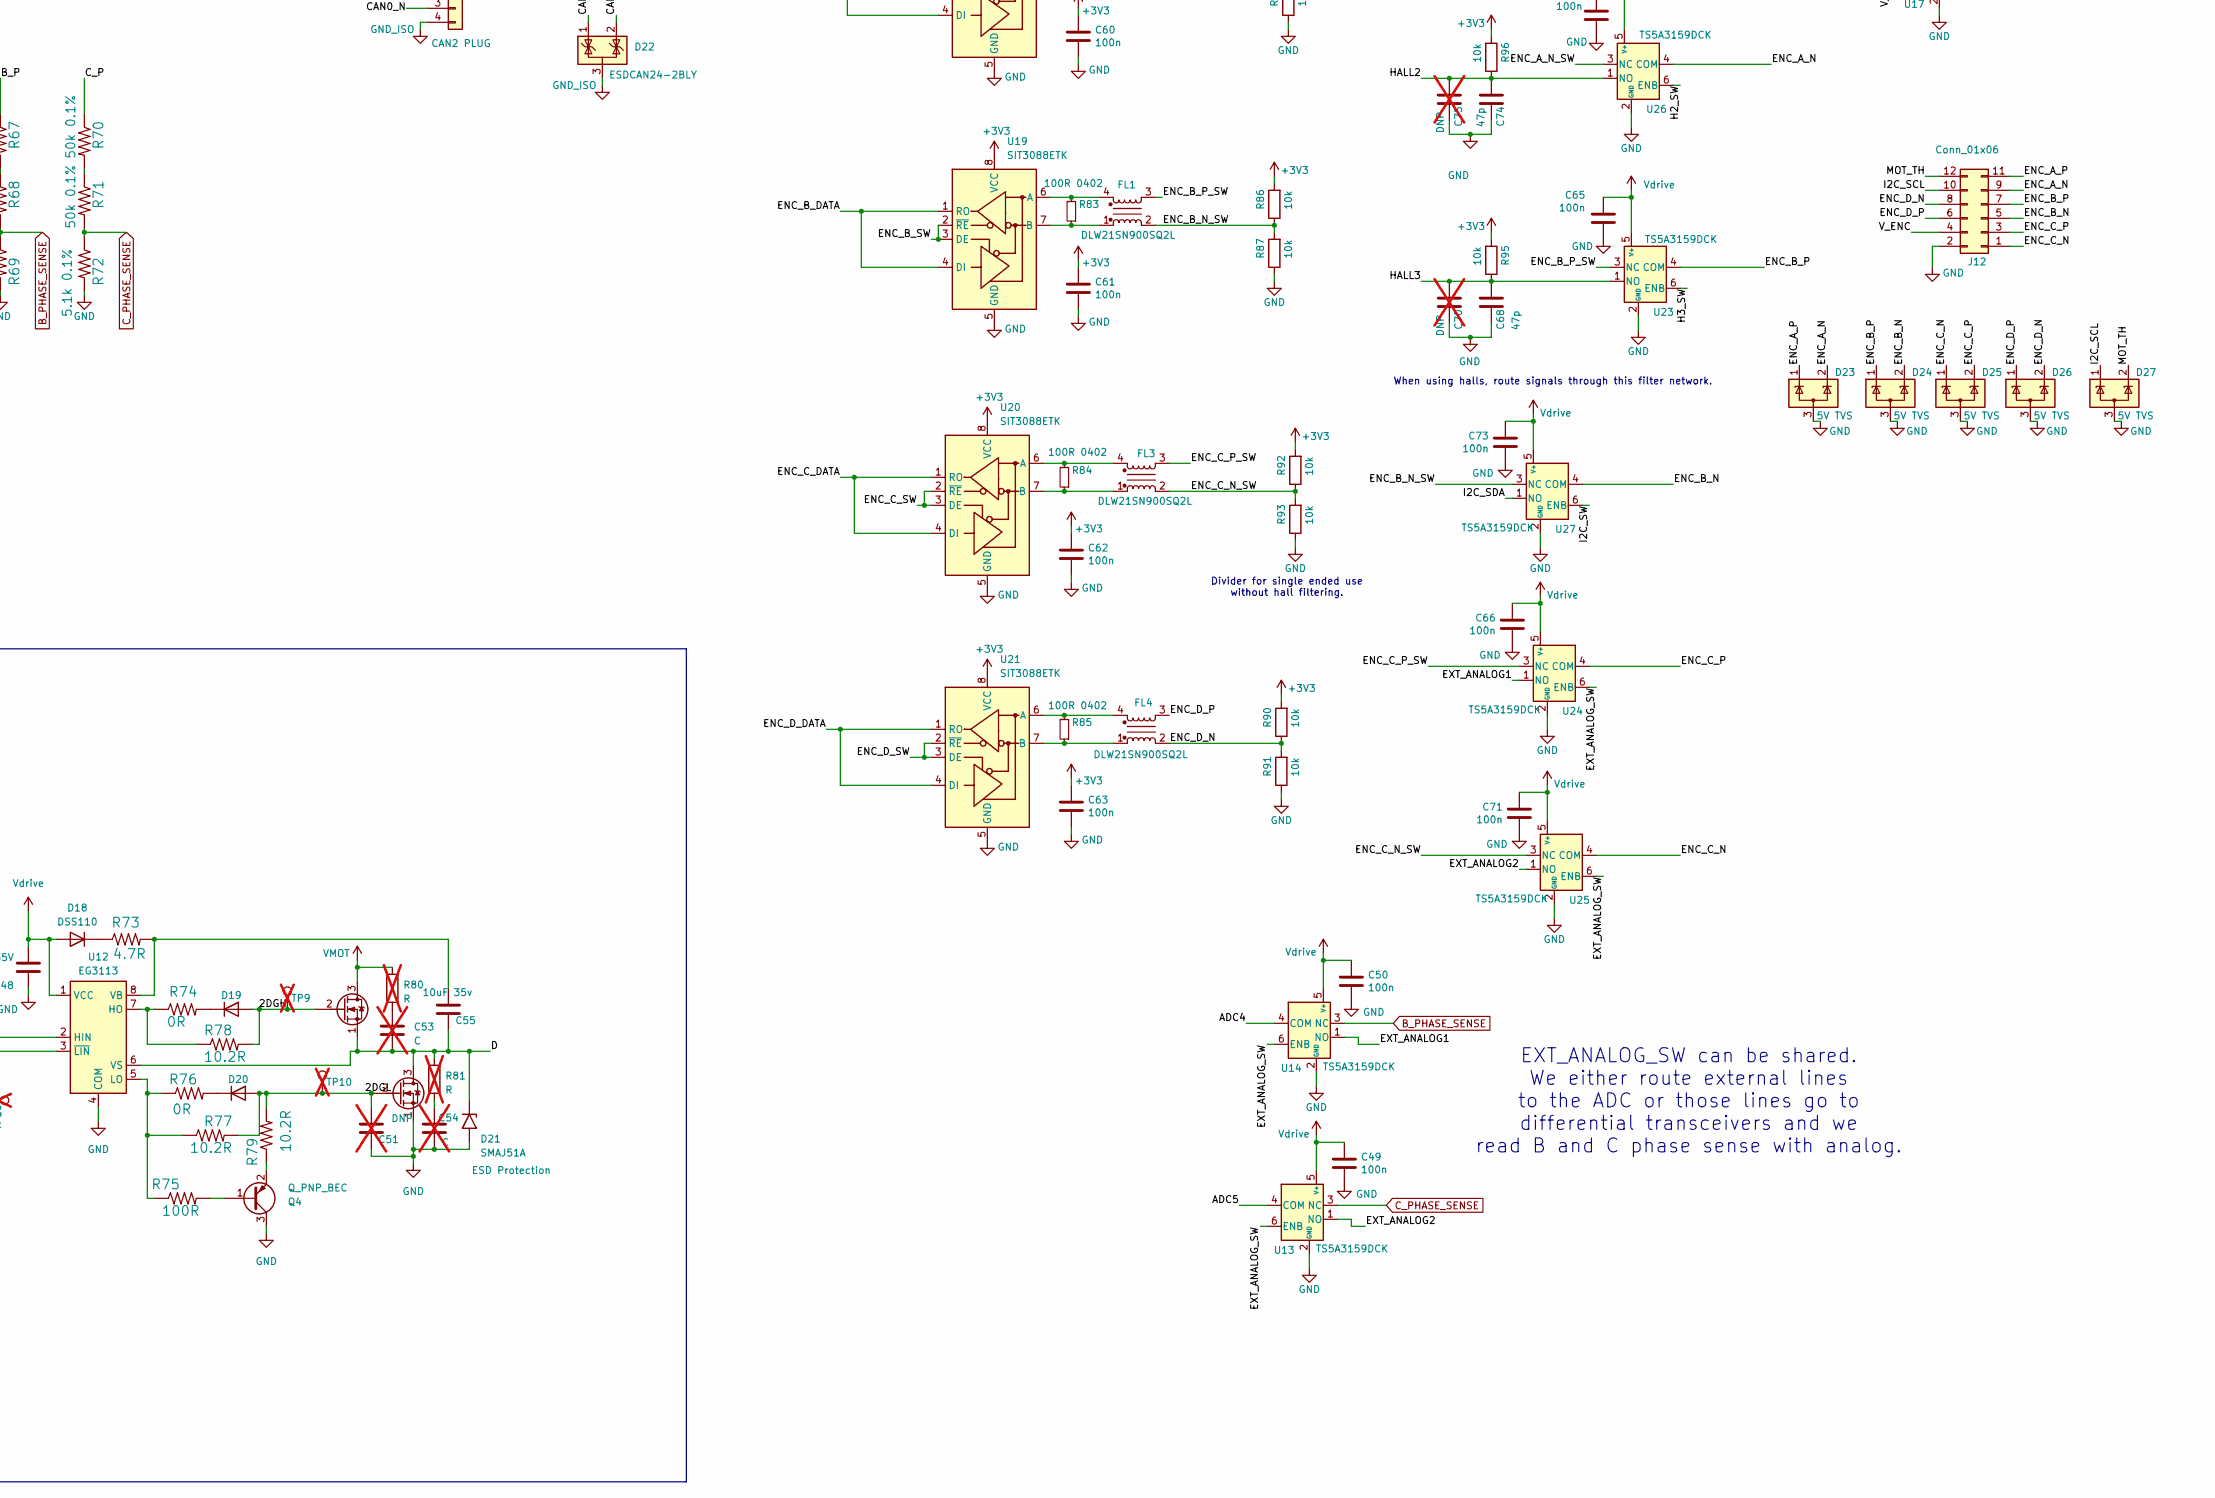
[picture p34: schematic rp2350_driver.kicad_sch, part in row 2, column 2]

Parts:
AH1: MOSFETSO-8; PowerPAK_SO-8_123; LCSC C501507
AL1: MOSFETSO-8; PowerPAK_SO-8_123; LCSC C501507
BH1: MOSFETSO-8; PowerPAK_SO-8_123; LCSC C501507
BL1: MOSFETSO-8; PowerPAK_SO-8_123; LCSC C501507
C1, C8, C44: 2.2uF 100V; C_1206_3216Metric; LCSC C650969
C2, C15, C27, C48: 4.7uF 35V; C_0603_1608Metric; LCSC C329940
C3: 33n; C_0402_1005Metric; LCSC C106862
C4, C20, C24, C30, C32, C35, C37, C38, C41, C43, C45, C46, C49, C50, C52, C59, C60, C61, C62, C63, C64, C65, C66, C71, C72, C73, C76, C79: 100n; C_0402_1005Metric; LCSC C131394
C5, C12, C47: 10u 25v; C_0805_2012Metric; LCSC C15850
C6, C23, C31, C51: DNP; C_0603_1608Metric; not fitted
C7, C9, C25, C26, C33, C34, C53, C54: C; C_0805_2012Metric; not fitted
C10, C28, C36, C55: 10uF 35v; C_0603_1608Metric; LCSC C194427
C11: 100uF ±20% 10V; CP_Elec_5x5.4; LCSC C191859
C13, C14: 15p; C_0402_1005Metric; LCSC C106997
C16, C29, C40: 100n; C_0603_1608Metric; LCSC C14663
C17, C18: 4.7u; C_0402_1005Metric_small_pads; LCSC C368809
C19: 1u; C_0603_1608Metric; LCSC C15849
C21, C22, C77: 4.7u; C_0402_1005Metric; LCSC C368809
C39: 100uF 100V; CP_Radial_D10.0mm_P5.00mm; MPN 1011001013R00; LCSC C2887236
C42, C80: 100uF 100V; CP_Radial_D10.0mm_P5.00mm; MPN 2210631013R00; LCSC C2887236
C56: 100n; C_0402_1005Metric; LCSC C14663
C57: 100n; C_0603_1608Metric
C58: 4.7uF 35V; C_0603_1608Metric; Voltage 35V; LCSC C329940
C67, C68, C74: 47p; C_0402_1005Metric; LCSC C20069324
C69, C70, C75: DNP; C_0603_1608Metric; LCSC C1671; not fitted
C78: 1u 100v; C_0603_1608Metric; LCSC C23829972
C81: 1uf 100v; C_0603_1608Metric; LCSC C23829972
C105, C106: 4.7uF 50V X5R; C_0805_2012Metric; LCSC C98192
C107, C108: 330pF 50V; C_0402_1005Metric; LCSC C106206
CH1, CH2: MOSFETSO-8; PowerPAK_SO-8_123; LCSC C501507
CL1, CL2: MOSFETSO-8; PowerPAK_SO-8_123; LCSC C501507
D1: WS2812B; LED_WS2812_3528_3.5x2.8mm_P1.5mm; LCSC C2890364
D3, D10, D14, D18: DSS110; D_SOD-123F; LCSC C2923942
D4: SS210; D_SMA; LCSC C14996
D5: SMDJ85A; D_SMC; LCSC C2990214
D6, D7, D11, D12, D15, D16, D19, D20: CDBU0130R-HF; D_SOD-523; LCSC C2886025
D9, D13, D17, D21: SMAJ51A; D_SMA; LCSC C366557
D22: ESDCAN24-2BLY; SOT-23; LCSC C5158050
D23, D24, D25, D26, D27, D28, D29: 5V TVS; SOT-883; LCSC C552559
FL1, FL2, FL3, FL4: DLW21SN900SQ2L; FILTER-SMD_4P-L2.0-W1.2-BL_DLW21H; LCSC C97856
H1, H2, H3, H4: MountingHole; MountingHole_3.9mm_Plastite_#6
J1, J2, J9: XT30; AMASS_XT30PW-M_1x02_P2.50mm_Horizontal; LCSC C431092
J3: USB_C_Receptacle_USB2.0; USB_C_Receptacle_XKB_U262-16XN-4BVC11; LCSC C2835315
J4, J6: SM03B-SRSS-TB; JST_SH_SM03B-SRSS-TB_1x03-1MP_P1.00mm_Horizontal; LCSC C2763613
J5: Estop Conn; BOOMELE-2510-3A_1x03_P2.54mm_Vertical; LCSC C509148
J7: Conn_01x03; PinHeader_1x03_P2.54mm_Horizontal; LCSC C492411
J8: Conn_01x03; PinSocket_1x03_P2.54mm_Horizontal; LCSC C2897385
J10: Power Output; AMASS_XT30PW-F_1x02_P2.50mm_Horizontal; LCSC C2913282
J11: CAN2 PLUG; PINREX-744-81-04TW00 _1x04_P2.54mm_Vertical; LCSC C2982033
J12: Conn_01x06; CONN12_5018761240_MOL; LCSC C493440
JP1: Jumper_2_Open; SolderJumper-2_P1.3mm_Bridged_RoundedPad1.0x1.5mm
L2: 3.3u; L_pol_2016; LCSC C42411119
L3: 47uH 1A; L_APV_ANR5045; LCSC C520357
Q1, Q2, Q3, Q4: Q_PNP_BEC; SOT-23; LCSC C686646
Q5: Q_NMOS_GDS; SOT-89-3; LCSC C7422896
R1, R2, R21, R22, R35, R36, R49, R65, R66: 10k; R_0603_1608Metric; LCSC C25804
R5, R57, R58, R86, R87, R88, R89, R90, R91, R92, R93, R94, R95, R96: 10k; R_0402_1005Metric; LCSC C60490
R6: 3.3k; R_0402_1005Metric; LCSC C2909345
R8, R24, R26, R34: 1k; R_0402_1005Metric; LCSC C11702
R9, R25, R41, R73: 4.7R; R_0603_1608Metric; LCSC C2907035
R10, R11, R27, R29, R42, R44, R74, R76: 0R; R_0603_1608Metric; LCSC C21189
R12, R28, R43, R53, R54, R75: 100R; R_0603_1608Metric; LCSC C22775
R13, R14, R15, R30, R31, R33, R45, R46, R47, R77, R78, R79: 10.2R; R_0603_1608Metric; LCSC C2933129
R17, R18, R37, R38, R48, R52, R80, R81: R; R_0805_2012Metric; not fitted
R20, R23, R39, R40, R55, R56: 8mΩ; R_2512_6332Metric; LCSC C2904240
R32: 33R; R_0402_1005Metric; LCSC C25105
R50, R51: 27; R_0402_1005Metric; LCSC C25100
R59, R60, R62, R63, R67, R68, R70, R71: 50k 0.1%; R_0603_1608Metric; LCSC C861451
R61, R64, R69, R72: 5.1k 0.1%; R_0603_1608Metric; LCSC C122969
R82: 100R; R_0402_1005Metric; LCSC C106232
R83, R84, R85: 100R 0402; R_0402_1005Metric; LCSC C106232
SW1, SW2: Button; KEY-SMD_4P-L4.2-W3.2-P2.20-LS4.6; LCSC C19724063
TH1: Thermistor 10k; R_0603_1608Metric; LCSC C13564
TP1, TP2, TP3, TP4, TP5, TP6, TP7, TP9, TP10: TestPoint; TestPoint_Pad_D1.5mm_no_courtyard; not fitted
TP8: TestPoint; TestPoint_Keystone_5019_Minature; LCSC C238130
TP12, TP13, TP14, TP15, TP16, TP17, TP18, TP19, TP20: TestPoint; TestPoint_Pad_D1.0mm; not fitted
U1, U6, U7, U12: EG3113; SOIC-8_3.9x4.9mm_P1.27mm; LCSC C480666
U3: W25Q16JV; IC_W25Q16JVUXIQ_TR; MPN W25Q16JVUXIQ; LCSC C2843335
U4: SPX3819M5-L-3-3; SOT-23-5; LCSC C20617301
U5, U9, U10: INA240A1D; SOIC-8_3.9x4.9mm_P1.27mm; LCSC C1346458
U8: RP2350_80QFN; RP2350-QFN-80-1EP_10x10_P0.4mm_EP3.4x3.4mm_ThermalVias; LCSC C42415655
U11: USBLC6-2P6; SOT-666; LCSC C2827693
U13, U14, U15, U17, U22, U23, U24, U25, U26, U27: TS5A3159DCK; SOT-363_SC-70-6; LCSC C46388
U16: CA-IS3052CG; SOIC-8_7.5x5.85mm_P1.27mm; LCSC C41784142
U18, U19, U20, U21: SIT3088ETK; DFN-8_L3.0-W3.0-P0.65-BL-EP; LCSC C601076
U28: XL7005A; SOIC-8-1EP_3.9x4.9mm_P1.27mm_EP2.29x3mm; LCSC C50848
U29: LM74700; SOT-23-6; LCSC C2941042
U101: FUSB302BMPX; WQFN-14-1EP_2.5x2.5mm_P0.5mm_EP1.45x1.45mm; LCSC C442699
Y1: ABM8-272-T3; Crystal_SMD_3225-4Pin_3.2x2.5mm; LCSC C20625731

Connections:
+1V1: C18.1, C20.1, C22.1, C24.1, L2.1, U8.10 (DVDD), U8.32 (DVDD), U8.51 (DVDD), U8.65 (VREG_FB)
+3V3: C4.1, C12.1, C16.1, C17.1, C19.1, C29.1, C30.1, C32.1, C35.1, C37.1, C38.1, C40.1, C41.1, C43.1, C45.1, C46.1, C47.1, C52.1, C56.1, C60.1, C61.1, C62.1, C63.1, C76.1, C77.1, R32.1, R57.2, R58.2, R86.2, R88.2, R90.2, R92.2, R94.2, R95.2, R96.2, TH1.1, U3.8 (VCC), U4.5 (OUT), U5.6 (V+), U5.7 (REF1), U8.5 (IOVDD), U8.15 (IOVDD), U8.24 (IOVDD), U8.29 (IOVDD), U8.41 (IOVDD), U8.50 (IOVDD), U8.59 (ADC_AVDD), U8.60 (IOVDD), U8.64 (VREG_VIN), U8.68 (USB_OTP_VDD), U8.69 (QSPI_IOVDD), U8.76 (IOVDD), U9.6 (V+), U9.7 (REF1), U10.6 (V+), U10.7 (REF1), U15.5 (V+), U16.1 (VCC1), U17.3 (NC), U18.8 (VCC), U19.8 (VCC), U20.8 (VCC), U21.8 (VCC), U101.3 (VDD), U101.4 (VDD), U101.12 (VCONN), U101.13 (VCONN)
+5V_ISO: C57.2, C58.2, J11.1, U16.8 (VCC2)
/2AGH: AH1.2 (G), D6.2 (A), R13.2, TP2.1
/2AGL: AL1.2 (G), C6.2, D7.2 (A), R14.2, R15.2, TP1.1
/2BGH: BH1.2 (G), D12.2 (A), R31.2, TP3.1
/2BGL: BL1.2 (G), C23.2, D11.2 (A), R30.2, R33.2, TP4.1
/2CGH: CH1.2 (G), D15.2 (A), R46.2, TP5.1
/2CGL: C31.2, CL1.2 (G), D16.2 (A), R45.2, R47.2, TP6.1
/2DGH: CH2.2 (G), D19.2 (A), R78.2, TP9.1
/2DGL: C51.2, CL2.2 (G), D20.2 (A), R77.2, R79.2, TP10.1
/ADC4: U8.55 (GPIO44_ADC4), U14.4 (COM)
/ADC5: U8.56 (GPIO45_ADC5), U13.4 (COM)
/A_N: D17.1 (A1), J1.1, R55.2, R56.2, U10.8 (+)
/A_P: AH1.1 (S), AL1.3 (D), C7.2, C10.1, R18.1, R20.1, R23.1, R62.1, U1.6 (VS), U5.1 (-)
/B_N: D13.1 (A1), J1.2, R39.2, R40.2, U9.8 (+)
/B_P: BH1.1 (S), BL1.3 (D), C25.2, C28.1, R38.1, R39.1, R40.1, R67.1, U6.6 (VS), U9.1 (-)
/CAN0_N: D22.1 (K), J11.3, U16.6 (CANL)
/CAN0_P: D22.2 (K), J11.2, U16.7 (CANH)
/CAN_CPU_RXI: U8.21 (GPIO21), U16.3 (RXD)
/CAN_CPU_TXO: U8.20 (GPIO20), U16.2 (TXD)
/C_N: D9.1 (A1), J2.1, R20.2, R23.2, U5.8 (+)
/C_P: C33.2, C36.1, CH1.1 (S), CL1.3 (D), R52.1, R55.1, R56.1, R70.1, U7.6 (VS), U10.1 (-)
/D: C53.2, C55.1, CH2.1 (S), CL2.3 (D), D21.1 (A1), J2.2, R81.1, U12.6 (VS)
/E-STOP: J5.1, U8.8 (GPIO10)
/ENC_A_DATA: U8.16 (GPIO16), U18.1 (RO), U18.4 (DI)
/ENC_A_N: D23.2 (K), J12.9, U26.4 (COM)
/ENC_A_N_SW: FL2.2, R88.1, R89.2, U26.3 (NC)
/ENC_A_P: D23.1 (K), J12.11, U22.4 (COM)
/ENC_A_P_SW: FL2.3, U22.3 (NC)
/ENC_A_SW: U8.27 (GPIO26), U18.2 (~RE), U18.3 (DE)
/ENC_B_DATA: U8.17 (GPIO17), U19.1 (RO), U19.4 (DI)
/ENC_B_N: D24.2 (K), J12.5, U27.4 (COM)
/ENC_B_N_SW: FL1.2, R86.1, R87.2, U27.3 (NC)
/ENC_B_P: D24.1 (K), J12.7, U23.4 (COM)
/ENC_B_P_SW: FL1.3, U23.3 (NC)
/ENC_B_SW: U8.28 (GPIO27), U19.2 (~RE), U19.3 (DE)
/ENC_C_DATA: U8.18 (GPIO18), U20.1 (RO), U20.4 (DI)
/ENC_C_N: D25.1 (K), J12.1, U25.4 (COM)
/ENC_C_N_SW: FL3.2, R92.1, R93.2, U25.3 (NC)
/ENC_C_P: D25.2 (K), J12.3, U24.4 (COM)
/ENC_C_P_SW: FL3.3, U24.3 (NC)
/ENC_C_SW: U8.36 (GPIO28), U20.2 (~RE), U20.3 (DE)
/ENC_D_DATA: U8.19 (GPIO19), U21.1 (RO), U21.4 (DI)
/ENC_D_N: D26.2 (K), FL4.2, J12.8, R90.1, R91.2
/ENC_D_P: D26.1 (K), FL4.3, J12.6
/ENC_D_SW: U8.37 (GPIO29), U21.2 (~RE), U21.3 (DE)
/EXT_ANALOG1: U14.1 (NO), U24.1 (NO)
/EXT_ANALOG2: U13.1 (NO), U25.1 (NO)
/EXT_ANALOG_SW: U8.46 (GPIO37), U13.6 (ENB), U14.6 (ENB), U24.6 (ENB), U25.6 (ENB)
/H1_SW: U8.43 (GPIO34), U22.6 (ENB)
/H2_SW: U8.44 (GPIO35), U26.6 (ENB)
/H3_SW: U8.45 (GPIO36), U23.6 (ENB)
/HALL1: C67.2, C69.2, R94.1, U8.39 (GPIO31), U22.1 (NO)
/HALL2: C74.2, C75.2, R96.1, U8.40 (GPIO32), U26.1 (NO)
/HALL3: C68.2, C70.2, R95.1, U8.42 (GPIO33), U23.1 (NO)
/I2C_SCL: D27.1 (K), J12.10, R58.1, U8.23 (GPIO23), U101.6 (SCL)
/I2C_SDA: R57.1, U8.22 (GPIO22), U27.1 (NO), U101.7 (SDA)
/I2C_SW: U8.14 (GPIO15), U27.6 (ENB)
/LED: D1.2 (DIN), U8.9 (GPIO11)
/MOT_TH: D27.2 (K), J12.12, U15.1 (NO)
/PD_INT: U8.48 (GPIO39), U101.5 (INT_N)
/QSPI_SCLK: U3.6 (CLK), U8.71 (QSPI_SCLK)
/QSPI_SD0: U3.5 (DI_(IO0)), U8.72 (QSPI_SD0)
/QSPI_SD1: U3.2 (DO_(IO1)), U8.74 (QSPI_SD1)
/QSPI_SD2: U3.3 (~WP_(IO2)), U8.73 (QSPI_SD2)
/QSPI_SD3: U3.7 (~HOLD_(IO3)), U8.70 (QSPI_SD3)
/QSPI_SS: R34.1, U3.1 (~{CS), U8.75 (QSPI_SS)
/RUN: SW2.4 (A), U8.35 (RUN)
/RXI_INTERBOARD_1: D28.2 (K), J7.2, U8.12 (GPIO13)
/RXI_INTERBOARD_2: D29.2 (K), J8.1, U8.26 (GPIO25)
/SWCLK: J6.1, U8.33 (SWCLK)
/SWD: J6.3, U8.34 (SWD)
/TH1_SENSE: R49.1, U8.58 (GPIO47_ADC7), U15.4 (COM)
/TH_SW_1: U8.38 (GPIO30), U15.6 (ENB)
/TXO_INTERBOARD_1: D28.1 (K), J7.1, U8.11 (GPIO12)
/TXO_INTERBOARD_2: D29.1 (K), J8.2, U8.25 (GPIO24)
/USB_D+: J3.A6 (D+), J3.B6 (D+), U11.6 (I/O1)
/USB_D-: J3.A7 (D-), J3.B7 (D-), U11.4 (I/O2)
/USB_DN: R51.1, U11.3 (I/O2)
/USB_DP: R50.1, U11.1 (I/O1)
/VREG_AVDD: C21.1, R32.2, U8.61 (VREG_AVDD)
/VREG_LX: L2.2, U8.63 (VREG_LX)
/V_ENC: J12.4, U17.4 (COM)
/V_SW: U8.13 (GPIO14), U17.6 (ENB)
/XIN: C13.1, U8.30 (XIN), Y1.1
/XOUT: R26.1, U8.31 (XOUT)
/~USB_BOOT: R34.2, SW1.4 (A)
A_PHASE_SENSE: R63.2, R64.1, U8.54 (GPIO43_ADC3)
A_PWM_H: R1.2, TP14.1, U1.2 (HIN), U8.79 (GPIO2)
A_PWM_L\: R2.2, TP15.1, U1.3 (~LIN), U8.80 (GPIO3)
A_SENSE: U5.5, U8.49 (GPIO40_ADC0)
B_PHASE_SENSE: R68.2, R69.1, U14.3 (NC)
B_PWM_H: R21.2, TP17.1, U6.2 (HIN), U8.1 (GPIO4)
B_PWM_L\: R22.2, TP16.1, U6.3 (~LIN), U8.2 (GPIO5)
B_SENSE: U8.52 (GPIO41_ADC1), U9.5
C_PHASE_SENSE: R71.2, R72.1, U13.3 (NC)
C_PWM_H: R35.2, TP12.1, U7.2 (HIN), U8.3 (GPIO6)
C_PWM_L\: R36.2, TP13.1, U7.3 (~LIN), U8.4 (GPIO7)
C_SENSE: U8.53 (GPIO42_ADC2), U10.5
D_PWM_H: R65.2, TP19.1, U8.6 (GPIO8), U12.2 (HIN)
D_PWM_L\: R66.2, TP18.1, U8.7 (GPIO9), U12.3 (~LIN)
GND: AL1.1 (S), BL1.1 (S), C1.2, C2.1, C4.2, C5.2, C6.1, C8.2, C9.2, C11.2, C12.2, C13.2, C14.2, C15.1, C16.2, C17.2, C18.2, C19.2, C20.2, C21.2, C22.2, C23.1, C24.2, C26.2, C27.1, C29.2, C30.2, C31.1, C32.2, C34.2, C35.2, C37.2, C38.2, C39.2, C40.2, C41.2, C42.2, C43.2, C44.2, C45.2, C46.2, C47.2, C48.1, C49.2, C50.2, C51.1, C52.2, C54.2, C56.2, C59.2, C60.2, C61.2, C62.2, C63.2, C64.2, C65.2, C66.2, C67.1, C68.1, C69.1, C70.1, C71.2, C72.2, C73.2, C74.1, C75.1, C76.2, C77.2, C78.1, C80.2, C81.2, C105.2, C106.2, C107.1, C108.1, CL1.1 (S), CL2.1 (S), D1.1 (GND), D4.2 (A), D5.2 (A2), D9.2 (A2), D13.2 (A2), D17.2 (A2), D21.2 (A2), D23.3 (A), D24.3 (A), D25.3 (A), D26.3 (A), D27.3 (A), D28.3 (A), D29.3 (A), J3.A1 (GND), J3.A12 (GND), J3.B1 (GND), J3.B12 (GND), J3.S1 (SHIELD), J4.2, J4.MP (MountPin), J6.2, J6.MP (MountPin), J7.3, J8.3, J9.1, J10.1, J12.2, Q1.3 (C), Q2.3 (C), Q3.3 (C), Q4.3 (C), R1.1, R2.1, R6.1, R8.2, R21.1, R22.1, R24.2, R35.1, R36.1, R49.2, R61.2, R64.2, R65.1, R66.1, R69.2, R72.2, R87.1, R89.1, R91.1, R93.1, SW1.1, TP7.1, TP8.1, U1.4 (COM), U3.4 (GND), U4.2 (GND), U5.2 (GND), U5.3 (REF2), U5.4 (GND), U6.4 (COM), U7.4 (COM), U8.62 (VREG_PGND), U8.81 (GND), U9.2 (GND), U9.3 (REF2), U9.4 (GND), U10.2 (GND), U10.3 (REF2), U10.4 (GND), U11.2 (GND), U12.4 (COM), U13.2 (GND), U14.2 (GND), U15.2 (GND), U16.4 (GND1), U17.2 (GND), U18.5 (GND), U19.5 (GND), U20.5 (GND), U21.5 (GND), U22.2 (GND), U23.2 (GND), U24.2 (GND), U25.2 (GND), U26.2 (GND), U27.2 (GND), U28.4 (EN), U28.5 (GND), U28.6 (GND), U28.7 (GND), U28.8 (GND), U28.9 (GND), U29.2 (GND), U101.8 (GND), U101.9 (GND), U101.15 (GND), Y1.2, Y1.4
GND_ISO: C57.1, C58.1, D22.3 (A), J11.4, U16.5 (GND2)
unnamed: C7.1, R17.2
unnamed: C9.1, R18.2
unnamed: C14.1, R26.2, Y1.3
unnamed: C25.1, R37.2
unnamed: C26.1, R38.2
unnamed: C33.1, R48.2
unnamed: C34.1, R52.2
unnamed: C53.1, R80.2
unnamed: C54.1, R81.2
unnamed: D3.1 (K), R9.1
unnamed: D4.1 (K), L3.1, U28.2 (SW)
unnamed: D6.1 (K), R10.2
unnamed: D7.1 (K), R11.2
unnamed: D10.1 (K), R25.1
unnamed: D11.1 (K), R27.2
unnamed: D12.1 (K), R29.2
unnamed: D14.1 (K), R41.1
unnamed: D15.1 (K), R42.2
unnamed: D16.1 (K), R44.2
unnamed: D18.1 (K), R73.1
unnamed: D19.1 (K), R74.2
unnamed: D20.1 (K), R76.2
unnamed: C108.2, J3.A5 (CC1), U101.10 (CC1), U101.11 (CC1)
unnamed: C107.2, J3.B5 (CC2), U101.1 (CC2), U101.14 (CC2)
unnamed: J5.3, R8.1
unnamed: C78.2, JP1.1 (A), Q5.2 (D), U29.4 (CATHODE)
unnamed: Q1.1 (B), R12.2
unnamed: Q1.2 (E), R15.1
unnamed: Q2.1 (B), R28.2
unnamed: Q2.2 (E), R33.1
unnamed: Q3.1 (B), R43.2
unnamed: Q3.2 (E), R47.1
unnamed: Q4.1 (B), R75.2
unnamed: Q4.2 (E), R79.1
unnamed: Q5.1 (G), U29.5 (GATE)
unnamed: R24.1, SW2.1
unnamed: R59.2, R60.1
unnamed: R62.2, R63.1
unnamed: R67.2, R68.1
unnamed: R70.2, R71.1
unnamed: R10.1, R13.1, U1.7 (HO)
unnamed: R11.1, R12.1, R14.1, U1.5 (LO)
unnamed: C10.2, R9.2, U1.8 (VB)
unnamed: R29.1, R31.1, U6.7 (HO)
unnamed: R27.1, R28.1, R30.1, U6.5 (LO)
unnamed: C28.2, R25.2, U6.8 (VB)
unnamed: R42.1, R46.1, U7.7 (HO)
unnamed: R43.1, R44.1, R45.1, U7.5 (LO)
unnamed: C36.2, R41.2, U7.8 (VB)
unnamed: R54.1, U8.77 (GPIO0)
unnamed: R53.1, U8.78 (GPIO1)
unnamed: TP20.1, U8.47 (GPIO38)
unnamed: R51.2, U8.66 (USB_DM)
unnamed: R50.2, U8.67 (USB_DP)
unnamed: R74.1, R78.1, U12.7 (HO)
unnamed: R75.1, R76.1, R77.1, U12.5 (LO)
unnamed: C55.2, R73.2, U12.8 (VB)
unnamed: TH1.2, U15.3 (NC)
unnamed: FL2.4, R82.2, U18.6 (A)
unnamed: FL2.1, R82.1, U18.7 (B)
unnamed: FL1.4, R83.2, U19.6 (A)
unnamed: FL1.1, R83.1, U19.7 (B)
unnamed: FL3.4, R84.2, U20.6 (A)
unnamed: FL3.1, R84.1, U20.7 (B)
unnamed: FL4.4, R85.2, U21.6 (A)
unnamed: FL4.1, R85.1, U21.7 (B)
unnamed: C3.2, R5.1, R6.2, U28.3 (FB)
unnamed: C79.1, U29.1 (VCAP)
RXI_DEBUG: J4.1, R53.2
TXO_DEBUG: J4.3, R54.2
VBUS: C79.2, C105.1, C106.1, J3.A4 (VBUS), J3.A9 (VBUS), J3.B4 (VBUS), J3.B9 (VBUS), Q5.3 (S), U11.5 (VBUS), U29.3 (EN), U29.6 (ANODE), U101.2 (VBUS)
VMOT: AH1.3 (D), BH1.3 (D), C1.1, C8.1, C39.1, C42.1, C44.1, C80.1, C81.1, CH1.3 (D), CH2.3 (D), D5.1 (A1), J9.2, J10.2, JP1.2 (B), R17.1, R37.1, R48.1, R59.1, R80.1, U28.1 (VIN)
VMOT_SENSE: R60.2, R61.1, U8.57 (GPIO46_ADC6)
Vdrive: C2.2, C3.1, C5.1, C11.1, C15.2, C27.2, C48.2, C49.1, C50.1, C59.1, C64.1, C65.1, C66.1, C71.1, C72.1, C73.1, D1.3 (VDD), D3.2 (A), D10.2 (A), D14.2 (A), D18.2 (A), L3.2, R5.2, U1.1 (VCC), U4.1 (IN), U4.3 (EN), U6.1 (VCC), U7.1 (VCC), U12.1 (VCC), U13.5 (V+), U14.5 (V+), U17.1 (NO), U17.5 (V+), U22.5 (V+), U23.5 (V+), U24.5 (V+), U25.5 (V+), U26.5 (V+), U27.5 (V+)

Notes on the sheet:
I/O Switching
JST Debug Connector
Primary Flash
MOTOR
CONSIDER THERMISTOR VOLTAGE IF MOTOR HALLS RUN AT 5V (or punt!?)
Differential tranceivers
Power
CPU: Single Ended I/O
12MHz Crystal
Encoder I/O
CPU: Analog Halls I2C
Sits directly under motor capacitors so no separate large input capacitance.
80 volt components, derate to 65-70 volts for operation 20 Amp max continuous current draw (estimated, depends on thermals) 50 Amp peak absolute maximum
Changelog: July 16 2024 Change low side pullups to pulldowns so that low side FET is on by default.
Note: Dual current sense resistors are used to allow for easier use at lower power levels. Remove one resistor or order boards with only one stuffed for more resolution at lower power.
Divider for single ended use without hall filtering.
EXT_ANALOG_SW can be shared. We either route external lines to the ADC or those lines go to differential transceivers and we read B and C phase sense with analog.
Encoder Supports: Single Ended I2C Hall Sensors Differential or Single Ended SPI Differential or Single Ended Quadrature with Index Dual Channel Analog
Additional Switching
Input Voltage Sense
When using halls, route signals through this filter network.
Motor Phase B/C Sense
