sequoia-hope/rp2350-motor-controller/hardware/rp2350_driver.kicad_pcb

## KiCad design hardware/rp2350_driver.kicad_pcb (continued)

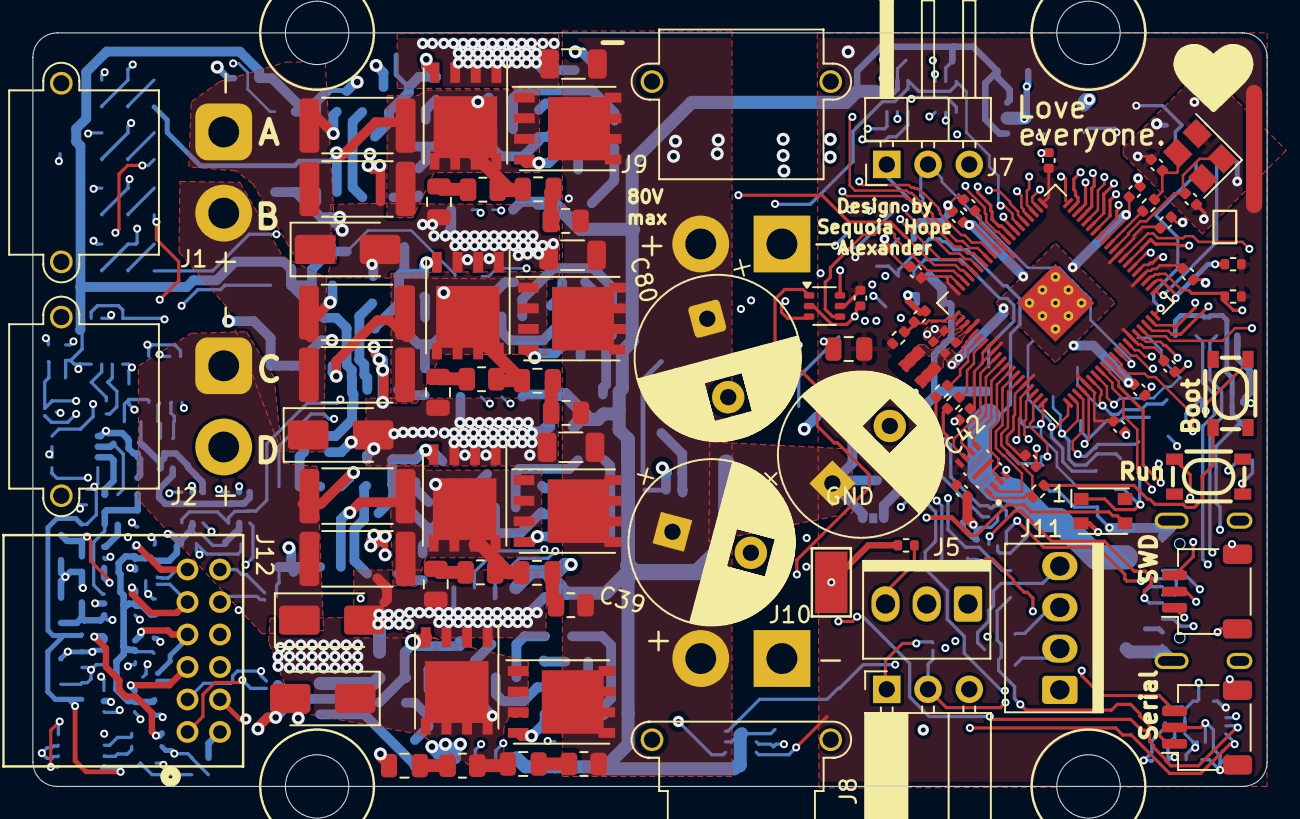
[picture p35: board rp2350_driver.kicad_pcb from above]

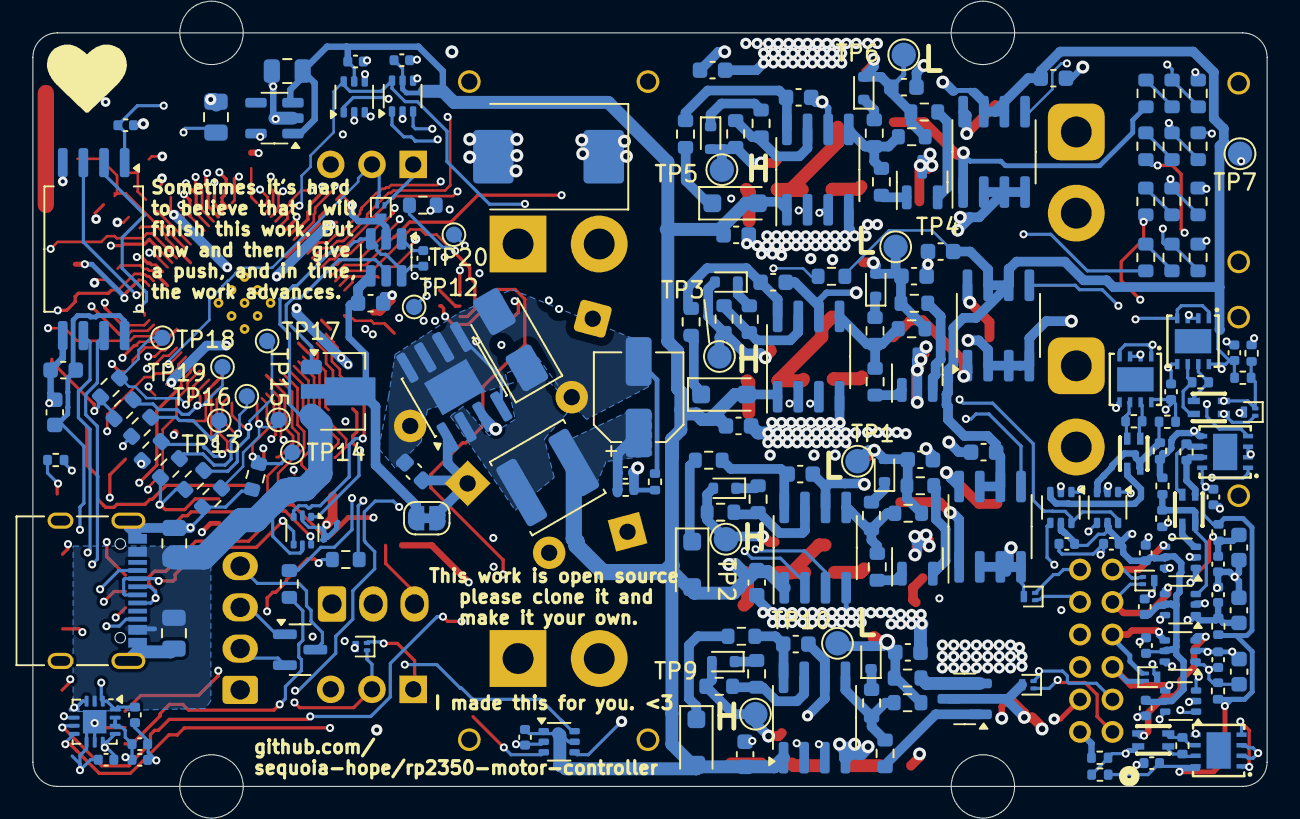
[picture p36: board rp2350_driver.kicad_pcb from below]

Board: 6 copper layers, 76.0 x 46.4 mm, 291 parts (199 on the bottom side), 178 nets.
