sequoia-hope/rp2350-motor-controller/hardware/encoder/rp2350_encoder.kicad_pcb

## KiCad design hardware/encoder/rp2350_encoder.kicad_pcb (2026-05-27)

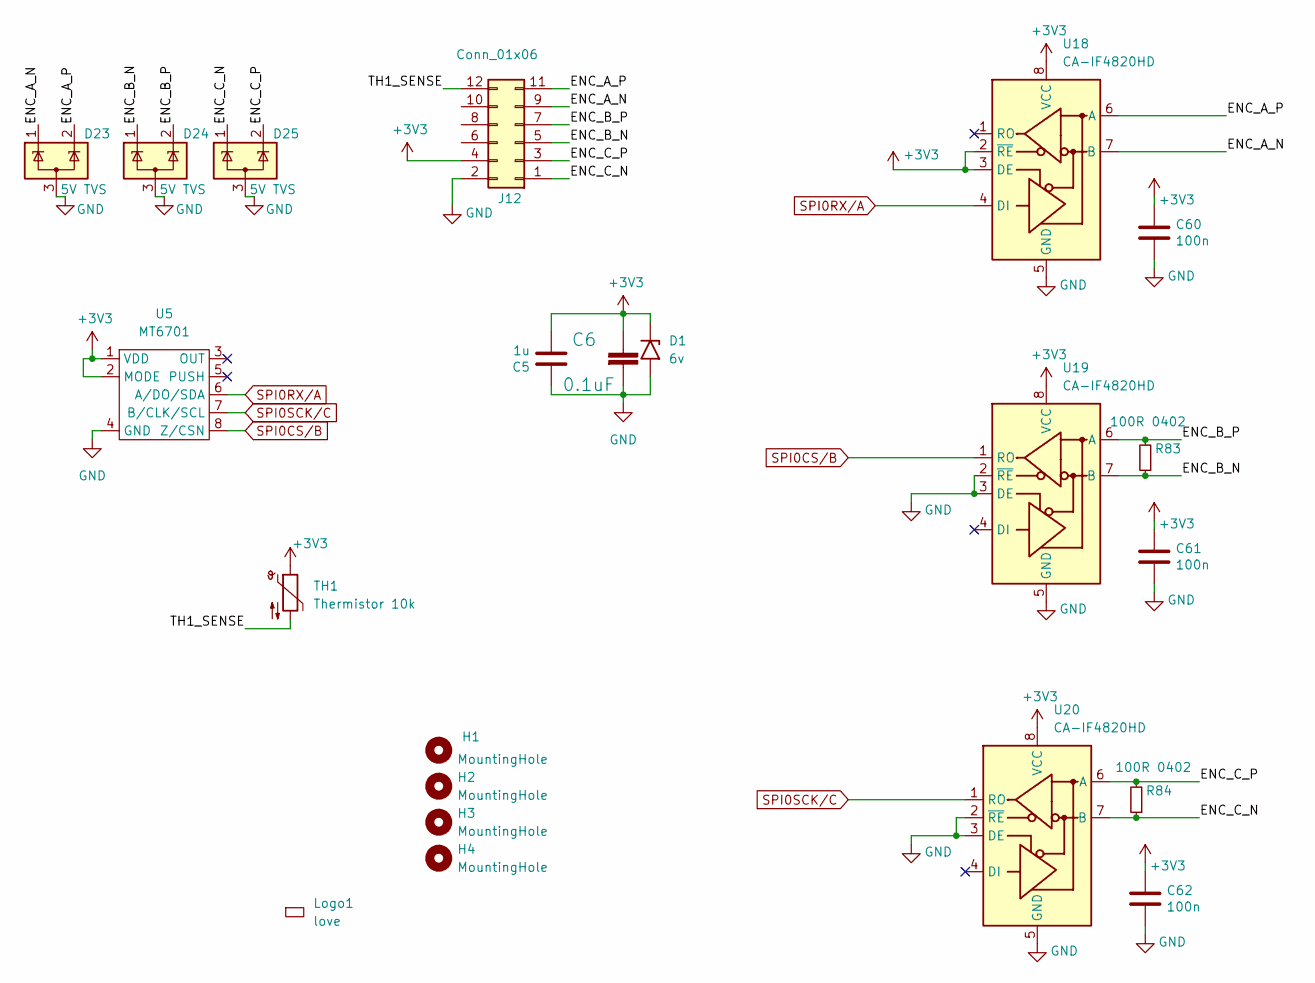
[picture p37: schematic rp2350_encoder.kicad_sch]

Parts:
C5: 1u; C_0603_1608Metric; LCSC C15849
C6: 0.1uF; C_0603_1608Metric; LCSC C14663
C60, C61, C62: 100n; C_0402_1005Metric; LCSC C131394
D1: 6v; D_SOD-123F; LCSC C2922753
D23, D24, D25: 5V TVS; SOT-883; LCSC C552559
H1, H2, H3, H4: MountingHole; MountingHole_3.1mm
J12: Conn_01x06; CONN12_5018761240_MOL; LCSC C493440
Logo1: love; love_small
R83, R84: 100R 0402; R_0402_1005Metric; LCSC C106232
TH1: Thermistor 10k; R_0603_1608Metric; LCSC C13564
U5: MT6701; SO-8_3.9x4.9mm_P1.27mm; LCSC C2856764
U18, U19, U20: CA-IF4820HD; DFN-8_L3.0-W3.0-P0.65-BL-EP; LCSC C6055596

Connections:
+3V3: C5.2, C6.1, C60.1, C61.1, C62.1, D1.1 (A1), J12.4, TH1.1, U5.1 (VDD), U5.2 (MODE), U18.2 (~RE), U18.3 (DE), U18.8 (VCC), U19.8 (VCC), U20.8 (VCC)
/ENC_A_N: D23.1 (K), J12.9, U18.7 (B)
/ENC_A_P: D23.2 (K), J12.11, U18.6 (A)
/ENC_B_N: D24.1 (K), J12.5, R83.1, U19.7 (B)
/ENC_B_P: D24.2 (K), J12.7, R83.2, U19.6 (A)
/ENC_C_N: D25.1 (K), J12.1, R84.1, U20.7 (B)
/ENC_C_P: D25.2 (K), J12.3, R84.2, U20.6 (A)
/TH1_SENSE: J12.12, TH1.2
GND: C5.1, C6.2, C60.2, C61.2, C62.2, D1.2 (A2), D23.3 (A), D24.3 (A), D25.3 (A), J12.2, U5.4 (GND), U18.5 (GND), U19.2 (~RE), U19.3 (DE), U19.5 (GND), U20.2 (~RE), U20.3 (DE), U20.5 (GND)
SPI0CS/B: U5.8 (Z/CSN), U19.1 (RO)
SPI0RX/A: U5.6 (A/DO/SDA), U18.4 (DI)
SPI0SCK/C: U5.7 (B/CLK/SCL), U20.1 (RO)

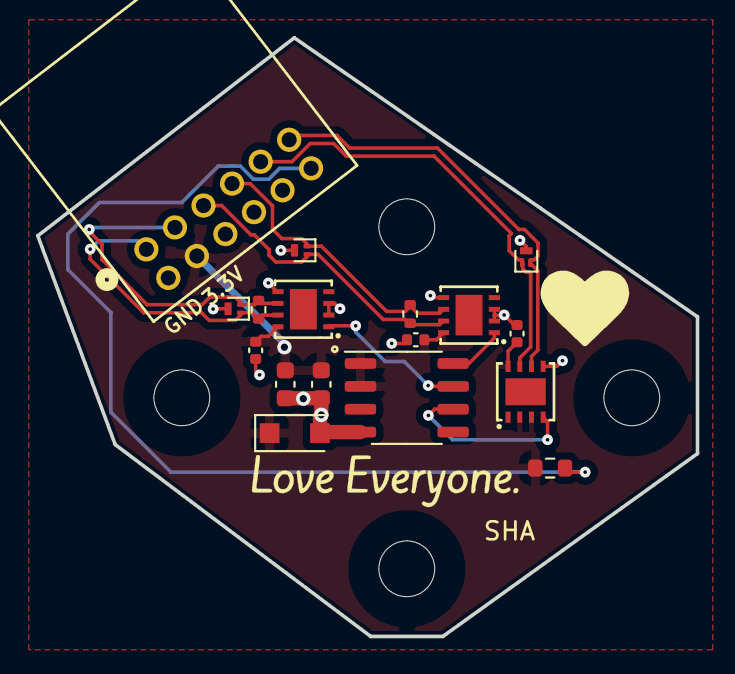
[picture p38: board rp2350_encoder.kicad_pcb from above]

Board: 2 copper layers, 36.7 x 33.3 mm, 22 parts (0 on the bottom side), 12 nets.
