sequoia-hope/rp2350-motor-controller/(commit log)

2024-11-16 Initial commit, rough schematic
    [rp2350_driver.kicad_pcb, rp2350_driver.kicad_sch]
2024-11-19 Add 4th bridge, update connectors
    [026605040.stp, 430451010.stp, 460073104.stp, rp2350_driver.kicad_pcb, rp2350_driver.kicad_sch]
2024-11-29 Refine design rules, make cpu fit rules, add gitignore
    [USB4125-GF-A-0190--3DModel-STEP-56544.STEP, rp2350_driver.kicad_pcb, rp2350_driver.kicad_sch]
2024-11-29 adjust stackup, rotate CPU, update via and trace defaults
    [RP2350_QFN80.step, rp2350_driver.kicad_pcb, rp2350_driver.kicad_sch]
2024-12-02 refining layout, beginning to sort out differential encoders
    [BM03B-SRSS-TB (copy).STEP, BM03B-SRSS-TB.STEP, PowerPAK-SO8.STEP, SM03B-SRSS-TB.STEP, rp2350_driver.kicad_pcb, rp2350_driver.kicad_sch, sk6812_1.5x1.5mm.step]
2024-12-18 progress on encoder connector and differential IC selection
    [CONN-TH_12P-P3.00_HC-MX3.0-2X6AW_1.obj, DFN-8_L3.0-W3.0-P0.65-BL-EP.obj, HDR-TH_12P-P2.00-H-M_PM200-2-06-W-4.3.obj, rp2350_driver.kicad_pcb, rp2350_driver.kicad_sch]
2025-01-19 update encoder section - multi encoder port maybe sorted
    [5018761240.stp, DFN-6_L1.6-W1.0-P0.50-BL.obj, FILTER-SMD_4P-L2.0-W1.2-BL_DLW21H.obj, SOT-723_L1.2-W0.8-P0.40-LS1.2-BR.obj, SOT-883-3_L1.0-W0.6-BR.obj, rp2350_driver.kicad_pcb]
2025-01-25 All components in board footprint. Big readme update.
    [KEY-SMD_4P-L4.2-W3.2-P2.20-LS4.6.obj, rp2350_driver.kicad_pcb, rp2350_driver.kicad_sch]
2025-01-25 Move board image to top of readme.
2025-07-28 100 percent routed and no DRC errors! needs massive review still.
    [rp2350_driver.kicad_pcb, rp2350_driver.kicad_sch]
2025-11-11 Cleaned up schematic encoder layout, fixed a sch/layout bug.
    [rp2350_driver.kicad_pcb, rp2350_driver.kicad_sch]
2025-11-12 Added USB-C PD, updated silk.
    [LM73100RPWR.STEP, LM73100RPWR.step, rp2350_driver.kicad_pcb, rp2350_driver.kicad_sch]
2025-11-14 Update schematic size, add PDF schematic.
    [rp2350_driver.kicad_pcb, rp2350_driver.kicad_sch]
2025-11-18 Swap ideal diode to something which supports VMOT
    [rp2350_driver.kicad_pcb, rp2350_driver.kicad_sch]
2025-11-18 Label credit card and business card size reference boxes
    [rp2350_driver.kicad_pcb]
2025-11-22 bunch of small trace cleanup
    [rp2350_driver.kicad_pcb, rp2350_driver.kicad_sch]
2026-01-20 Silly but complete routing of the 80v power supply
    [rp2350_driver.kicad_pcb, rp2350_driver.kicad_sch]
2026-01-20 minor tweaks
    [rp2350_driver.kicad_pcb]
2026-04-19 Whether inadvisedly or not, I have ordered this rev
    [LM73100_Design_Calculator.xlsm, rp2350_driver.kicad_pcb, rp2350_driver.kicad_sch]
2026-04-28 Fix a few parts as per corrections made during order.
    [rp2350_driver.kicad_pcb, rp2350_driver.kicad_sch]
2026-05-27 Add encoder plus updated motor driver files.
    [CONN-TH_6P-P2.54_HCTL_HC-2510-6AW.obj, Molex_90Grad_5er.STEP, Molex_90Grad_6er.STEP, board.step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]
2026-05-27 Add firmware, move hardware to hardware directory.
    [026605040.stp, 430451010.stp, 460073104.stp, 5018761240.stp, BM03B-SRSS-TB (copy).STEP, BM03B-SRSS-TB.STEP, CONN-TH_12P-P3.00_HC-MX3.0-2X6AW_1.obj, CONN-TH_6P-P2.54_HCTL_HC-2510-6AW.obj]
2026-05-27 remove incorrect max voltage silk
    [rp2350_driver.kicad_pcb]
2026-07-17 Add hall sensor motor config, UART debug serial, and tuning improvements
    Generalize the firmware to support two motor configurations selected at
    build time via MOTOR_CONFIG:
    MOTOR_MT6701 (default) - MT6701 magnetic encoder over SPI, 20mOhm shunts
    MOTOR_HALLS - hall sensors on GPIO 31/32/33, 10mOhm shunts
    The shunt resistor value, pole pairs, sensor wiring, PID gains, and
    voltage_sensor_align now follow the selected config. Board I/O switches
    route to either the differential transceivers (encoder) or the hall
    inputs. Adds a new motor_halls PlatformIO environment.
    Hall support includes an auto-scan that drives the motor open-loop to
    determine the correct hall pin order, persi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
    [main.cpp, serial_debug.py, tune.py]
2026-07-17 Fix calibration-save deadlock and param queries returning text
    Saving calibration hung the board every time. save_calibration() opens
    LittleFS for write, which parks the second core before erasing flash:
    save_calibration -> LittleFS open -> lfs_flash_prog
    -> RP2040::idleOtherCore -> __freertos_idle_other_core (spins forever)
    __freertos_idle_other_core() notifies core1's idle task and busy-waits on
    __otherCoreIdled, which never gets set. The board wedges with interrupts
    still servicing the UART FIFO, so it looks alive at the wire but stops
    answering commands and needs a reset.
    FreeRTOS was never asked for -- it is absent from the dependency graph and
    unreferenced by our source -- bu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
    [main.cpp]
2026-07-17 Apply motor tuning in setup(), not only initHardware()
    The PID/LPF/limit defaults were set inside initHardware(), which runs on
    H and early-returns once hw_initialized. Before that, the motor object
    still held SimpleFOC's library defaults, so a query answered with values
    we never intended:
    MQI curr I 300.000 (want 0.3)
    MVI vel I 10.000 (want 0.1)
    MVR vel ramp -12345.000 (NOT_SET sentinel)
    MQP curr P 3.000 (want 0.6)
    tune.py's read_params runs 500ms after page load -- before the user has
    run H -- and correctly loaded those into the dashboard inputs, silently
    replacing the HTML defaults that did match the firmware. Reading is the
    right behaviour; the controller was simp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
    [main.cpp]
2026-07-17 Stop per-iteration serial logging from throttling the FOC loop
    The step-test loops printed a CSV row on every FOC iteration. That was
    free when SERIAL_PORT was USB CDC -- a buffered 12Mbit/s bulk pipe -- but
    62e89cf moved the console to Serial1, a 115200 UART whose print() blocks
    once the TX FIFO fills. The arithmetic lands right on the measurement:
    115200 baud = 11,520 B/s; ~28-byte CSV row -> 2.4ms per iteration
    measured: 1221 samples over 2997ms, avg 2.46ms -> 407 Hz
    So the control loop ran at 407Hz while its gains assume a fast loop, and
    LPF_velocity.Tf=0.01 got ~4 samples per time constant. A current-mode FOC
    loop starved ~40x oscillates, which presents as far too much velocity g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
    [main.cpp]
2026-07-17 Buffer step-test samples to RAM; block serial while the sine demo runs
    Restore the step-test plots without putting the UART back in the control
    loop. Samples are captured into a RAM buffer during the FOC loop and dumped
    once it ends, where blocking is harmless. The log interval divides the run
    duration by the 2000-sample buffer (floor 1kHz), so a 3s sine logs every
    1.5ms and a 700ms Sq step logs at the full 1kHz. Costs ~104KB of 512KB SRAM
    (4.1% -> 22.2%).
    Measured: 1969 rows returned AND foc_iters=60931 in 3000ms -> 20310 Hz.
    Previously it was one or the other -- printing per iteration gave plots at
    407Hz, dropping the rows gave 16kHz and no data.
    Block serial output while the sine demo r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
2026-07-17 Add DEMO_MODE: self-starting continuous sine on power-up
    Waits for motor power -- either a negotiated USB PD 20V contract or any
    VMOT above DEMO_MIN_VMOT, so a bench supply arms it too -- then loads
    calibration from flash and runs a continuous sine at 50 rad/s, 2000ms
    period (0.5Hz). Armed at 10Hz rather than spun on, since readVMOT() falls
    back to analogRead() before the ADC engine is up. One shot: it never
    retries, even if a step fails.
    demoTick() mirrors doCalibration('l') -- initHardware() and the
    enc_detected check, THEN load_calibration_and_init(). The name suggests
    that function inits the hardware itself; it does not. Skipping the init
    made initFOC() run against an uninitialised driv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
    [main.cpp]
2026-07-17 Clamp current_limit below current-sense saturation; disable DEMO_MODE
    current_limit was 5.0A on a board whose 20mOhm shunts saturate the INA240
    at 4.12A:
    I_sat = 1.65V / (0.020 * 20) = 4.12A (400 mV/A into 1.65V headroom)
    Past I_sat the measured current stops rising while the real current keeps
    climbing. PID_current_q then sees a too-low current, winds up, and commands
    MORE voltage -- positive feedback with the sense chain blind, bounded only by
    voltage_limit and the winding resistance. The loop was allowed to command
    0.88A of current it could not see.
    The ~4A ceiling was already known -- it is why voltage_sensor_align was cut
    from 2.0 to 1.0 -- but it was never applied to curren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
2026-07-17 Set current_limit to 4A and re-enable DEMO_MODE
    Raise the clamp ceiling from 70% to 98% of current-sense saturation so a 4A
    limit passes unmodified:
    20mOhm shunts, 20x gain -> sense saturates at 4.12A
    clamp ceiling -> 4.04A
    current_limit -> 4.00A (unclamped)
    The clamp still does its job: current_limit cannot exceed what the sense
    chain can measure, via config or via MLC from the dashboard, so the current
    loop can never command current it is blind to. That was the actual defect --
    the old 5.0A limit sat above the 4.12A saturation point.
    DEMO_MODE back to 1 per request. Flashed and verified building; the board
    self-starts on PD 20V or VMOT > 15V.
    Note for whoeve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
2026-08-09 Fix dashboard.py: stale output path and restart-safe bind
    Two bugs kept the debug dashboard from serving at all.
    The generated HTML was written to an absolute path under
    ~/Software/motor-firmware, which stopped existing when the firmware moved into
    this repo. That write happens before the server starts, so the stale path took
    the whole dashboard down with a FileNotFoundError. Write it next to the script
    instead.
    socketserver.TCPServer leaves allow_reuse_address False, unlike
    http.server.HTTPServer. After stopping the dashboard the port stays in
    TIME_WAIT, so an immediate restart died with "Address already in use" — which
    made it look intermittent, since a restart after a long enough paus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
    [dashboard.py]
2026-08-09 Snapshot as-found working tree before rev-B fixes
    - hardware/rp2350_driver.kicad_pcb: zone-refill coordinate churn only (no
    design change; from reopening the board in KiCad)
    - firmware/dashboard.html: runtime-regenerated status snapshot, overwritten
    when the registry auto-launched the (since-deprecated) debug dashboard
    - launch.sh: standard agent-session launcher written by `proj add`
    [rp2350_driver.kicad_pcb]
2026-08-09 Ignore tmp/ scratch and Python bytecode caches
    tmp/ holds a saved JLCPCB cart page and a virtualenv — local scratch, not
    project sources.
2026-08-09 Add design-review site (served via project registry on :8011)
    review/: hub page + schematic and PCB review sub-pages with renders,
    schematic crops, and the courtyard-relaxation previews. review/tools/ holds
    the pcbnew-based spacing solver and its placement data. Registered as this
    project's web instance (replacing the debug-dashboard promotion).
2026-10-02 Firmware: drive all mux controls at boot; README: honest specs
    - initSwitchGpios() runs first thing in setup(): every TS5A3159 enable and
    SIT3088 DE/RE line is driven to a safe default (V_ENC=3.3V, receive,
    alternate paths off, termination open) instead of floating until the 'H'
    command. Matters most on rev A boards, which have no pull-downs
    - New pin defs: ENC_D_SW, I2C_SW, EXT_ANALOG_SW, TH_SW, and rev B's
    TERM_EN (GPIO38); MT6701 config closes the termination, halls leave it
    open. Harmless on rev A (GPIO38 only reaches TP20)
    - README: voltage claim now distinguishes rev A (~48V: 51V phase TVS, 80V
    FETs) from rev B (60V); adds the shunt/current-range table and the
    encoder sin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
2026-10-02 Firmware: bus overvoltage guard + brake chopper on the D leg (F-28)
    busGuard(), called every loop() pass and in the step-test spin loops:
    - Always on: folds motor->current_limit toward zero across 63-66V (less
    braking torque = less regen) and restores the user's limit on recovery.
    Self-throttled VMOT sampling: RAM read at ~FOC rate via the DMA engine,
    500Hz one-shot before init. 310uF between 60V and TVS breakdown is only
    ~0.22J and slews 13V/ms at 4A -- a slow guard would miss the event
    - Behind -DBRAKE_CHOPPER=1: proportional 64-66V chopper on the D high side
    (GPIO8, 20kHz hardware PWM, 95% duty cap for bootstrap refresh) with an
    I2t accumulator modeling the resistor's thermal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
2026-10-02 review: retract F-13 -- the EG3113 does have shoot-through protection
    F-13 recorded "EG3113 has no shoot-through protection, firmware dead-time is
    load-bearing". That was wrong, and it was wrong because the datasheet was
    never read at review time. Reading it now (EGmicro V1.2, 2017-08-19, pulled
    from the vendor's own static/doc tree since LCSC and Alldatasheet both block
    direct download) contradicts the claim on both counts:
    §1 features list built-in dead-time control circuit; interlock that
    "categorically prevents high and low outputs conducting
    together"
    §5 block diagram interlock and dead-time stages drawn as discrete blocks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
    [main.cpp]
2026-10-02 firmware: track CLAUDE.md instead of ignoring it
    The file has been ignored since 344bbfc, which made sense when it was a
    scratch note. It is not that any more -- it carries hardware claims and
    debugging conclusions that nothing else in the repo records:
    - the SWD/OpenOCD flashing recipe and why picotool/BOOTSEL is avoided
    - the probe UART bridge wedge, which is indistinguishable from a crashed
    board and cost real debugging time before it was understood
    - why the FOC loop must never print (407Hz vs ~20kHz)
    - why FreeRTOS must stay unlinked, and the LittleFS deadlock it causes
    - the RP2350 USB CDC global-constructor bug
    - the brake chopper / bus guard behaviour tied to F-28
    I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
2026-10-02 Firmware: plateau mode for the sine demo, drift-free phase clock
    Y<amp>[,<freq>[,<plateau_s>]] -- a non-zero plateau holds each sine peak
    at +/-amplitude for that many seconds before ramping to the other
    direction, so a long run spends most of its time at constant speed
    (thermal soak, bearing/acoustic checks). The ramps keep the sine's
    acceleration profile, so the tuned velocity gains still apply.
    DEMO_MODE now runs 40 rad/s, 0.5Hz with a 10s plateau.
    The phase is accumulated in whole ms and wrapped once per cycle instead
    of recomputed from (millis() - t0) as float seconds, which lost ~4ms of
    resolution after half a day and quantised the velocity target. The
    period is rounded to whole ms so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
    [debug.py, main.cpp]
2026-10-16 Demo bring-up: LED states, LittleFS mount check, tuned limits
    Brings demo-led-fsmount (b12fd9e) onto main: the LED_* status palette with
    the demo's arming/running/error states, the bench-tuned MT6701 limits
    (current 3.9 A, voltage 8 V, velocity 50 rad/s, tune.py defaults to match),
    and fsMount() on both calibration paths.
    The fsMount() comments are corrected from the original. arduino-pico's
    LittleFS.begin() already formats and retries on a failed mount (autoFormat
    defaults to true), so the read path does format, and the save-path retry is
    a second attempt. fsMount() adds logging but does not stop the power-cut
    brick the original commit describes (begin() mounts, open() hardfaults);
    that st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
2026-10-16 Calibration: power-cut-safe flash slots replace LittleFS
    A power cut during Cs could leave the board with no usable calibration,
    which the demo reports as "no valid calibration" and the orange LED.
    Root cause, from a host simulation of the old save with the framework's own
    littlefs v2.10, arduino-pico's config and its wrapper's exact call sequence
    (host_test/littlefs_powercut.c): File open("w") calls lfs_file_sync() right
    away, committing the truncated empty file before any data is written. 37%
    of power-cut points left an EMPTY calibration.txt; 7% kept the old one.
    littlefs itself never asserted, faulted (ASan/UBSan) or failed to mount in
    11,844 trials, so the earlier "open() hardfaults on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
